weng1259/autospin/firmware/motor_control/README.md

# motor_control（已退役）

> ⚠️ **2026-04-13 起本目录的代码已停止维护**。
>
> 项目固件栈于 2026-04-13 迁移到 [grbl-Mega-5X](../grbl_spike/)，自研固件 `motor_control.ino`（Phase 2a/2b 版本）保留在此目录，**仅作 rollback snapshot**。
>
> - 当前固件配置见 [`docs/guides/04-grbl-固件配置.md`](../../docs/guides/04-grbl-固件配置.md)
> - 迁移背景见 [`docs/decision-log/ADR-001-migrate-to-grbl-stack.md`](../../docs/decision-log/ADR-001-migrate-to-grbl-stack.md)
> - 本目录的旧文档已归档到 [`docs/legacy/04-自研固件开发-archived.md`](../../docs/legacy/04-自研固件开发-archived.md) 和 [`docs/legacy/05-自研固件测试-archived.md`](../../docs/legacy/05-自研固件测试-archived.md)
>
> **不要在这里加新功能**。如果未来 grbl 路线出问题需要回滚，按 ADR-001 §回滚条件操作。
