weng1259/autospin/docs/hardware-specs.md

# 硬件特征表

> 从产品画册和驱动器手册中提取的关键参数，固件开发前必读。
>
> 数据来源标注：📘 = 产品画册, 📗 = 驱动器手册, 🔧 = 实测

---

## 一、运动模组（GH40）

> 📘 产品画册 p5 命名规则 + p8 40型号参数

| 参数 | 值 | 来源 |
|---|-----|---|
| 型号 | GH40-D75-X300S-Y300S-Z100S-57 | 铭牌 |
| 宽度 | 40mm | 📘 p8 |
| 传动方式 | **同步带**（非丝杆） | 📘 p8 |
| 同步带规格 | PU-HTD3M-15(钢丝)，齿距 3mm，带宽 15mm | 📘 p8 |
| 同步轮齿数 | **25 齿** | 📘 p8 |
| 导程 | **75mm/转**（25齿 × 3mm） | 📘 p8 |
| 最大速度 | ≤1.5 m/s | 📘 p8 |
| 重复定位精度 | ≤0.1mm | 📘 p8 |
| 直线度/回转差 | ≤0.05mm/300mm | 📘 p8 |
| 行程 | X=300mm, Y=300mm, Z=100mm | 铭牌 |

---

## 二、驱动器（2HSS57-C）

> 📗 驱动器手册

### 2.1 技术指标（📗 p9）

| 参数 | 值 |
|---|-----|
| 输入电压 | 24~60VDC（典型 36V，实际使用 24V） |
| 连续电流 | 4.5A 20kHz PWM |
| **最大脉冲频率** | **200kHz** |
| 保护 | 过流 8A±10%、过压 70VDC、位置超差可调 |

### 2.2 脉冲时序要求（📗 p13）

| 参数 | 最小值 | 固件实际值 |
|---|---|---|
| 脉冲宽度（t3/t4） | **≥ 2.5μs** | 当前最小 25μs（SPEED 9） |
| DIR 建立时间（t2） | **≥ 6μs** | 10μs |
| ENA 建立时间（t1） | ≥ 5μs | — |

### 2.3 拨码开关设置（📗 p14-16）

当前三台驱动器相同设置：

| 开关 | 状态 | 功能 |
|---|---|---|
| SW1 | OFF | 单脉冲模式（脉冲+方向） |
| SW2 | OFF | 默认方向（CCW） |
| SW3 | OFF | 细分设置 ↓ |
| SW4 | OFF | 细分设置 ↓ |
| SW5 | OFF | 细分设置 ↓ |
| SW6 | ON | → 组合 = **51200 细分/转** |
| SW7 | OFF | 指令平滑关闭 |
| SW8 | **OFF** | **闭环模式**（需 DB9 编码器） |

### 2.4 报警代码（📗 p16）

| 红灯闪烁次数 | 故障 | 备注 |
|---|---|---|
| 1 | 驱动器过流 | |
| 2 | 内部电压参考错误 | |
| 3 | 参数上传错误 | |
| 4 | 供电电压超过最大值 | |
| **5** | **位置偏差超限** | 🔧 Z轴刹车未释放时出现过 |
| 6 | 电机缺相 | |

### 2.5 关键内部参数（📗 p19-20）

| 参数 | 名称 | 默认值 | 说明 |
|---|---|---|---|
| P15 | 编码器线数选择 | 0 | 0=1000线, 1=2500线 |
| P16 | 位置超差阈值 | 400（×10=4000 counts） | 超过此值触发报警5 |
| P19 | 指令平滑 | 2 | |
| P20 | 自定义细分 | 8（×50=400） | SW3-6全ON时生效 |
| P22 | 脉冲滤波 | 3 | |

### 2.6 接线方式（📗 p10 + p18）

- 控制信号：**共阳极**接法（Arduino 5V → PLS+/DIR+，GPIO → PLS-/DIR-）
- 编码器：1000 线，四倍频计数 → 4000 counts/转（📗 p18）
- 刹车输出：集电极开路，需外接 24V + 继电器（📗 p6）
- ENA+/ENA-：当前悬空未接

---

## 三、计算参数

### 3.1 步距计算

```
每转脉冲数 = 51200（DIP 开关设定）
每转行程 = 75mm（同步带 25齿 × 3mm 齿距）
步距 = 51200 ÷ 75 = 682.67 步/mm
```

> ~~旧值"68.3步/mm"和"80步/mm"均不正确，来自早期"闭环÷10"的错误假设。~~
> **2026-03-26 已实测确认**：MOVE 6827 步 ≈ 10mm，682.67 步/mm 正确。

### 3.2 行程范围（步数）

| 轴 | 行程 mm | 步数（682.67步/mm） |
|----|---|---|
| X | 300 | 204,800 |
| Y | 300 | 204,800 |
| Z | 100 | 68,267 |

### 3.3 速度换算

| 场景 | 脉冲频率 | 线速度 | 备注 |
|---|---|---|---|
| 驱动器上限 | 200 kHz | 293 mm/s | 📗 p9 |
| 模组上限 | — | 1500 mm/s | 📘 p8，远高于驱动器上限 |
| 固件 SPEED 9 | 20 kHz（25μs） | 29.3 mm/s | |
| 固件 SPEED 5 | 2.5 kHz（200μs） | 3.7 mm/s | |
| 固件 SPEED 1 | 250 Hz（2000μs） | 0.37 mm/s | |
| 归零快寻 | 16.7 kHz（30μs） | 24.4 mm/s | |
| 归零慢寻 | 1.67 kHz（300μs） | 2.4 mm/s | |

### 3.4 归零时间估算

| 轴 | 最大行程 | 快寻速度 | 最大耗时 |
|----|---|---|---|
| Z | 100mm | 24.4 mm/s | ~4s |
| X | 300mm | 24.4 mm/s | ~12s |
| Y | 300mm | 24.4 mm/s | ~12s |
| **全轴** | — | — | **~28s** |

---

## 四、各轴物理特征

> 🔧 以下参数从实机测试获得，手册/画册中无法直接查到

| 参数 | X 轴 | Y 轴 | Z 轴 |
|---|---|---|---|
| 固件 invertDir | **true** | false | **false** |
| 归零方向 | 负方向（左） | 负方向（前） | **正方向（上）** |
| homeDirectionPositive | false | false | **true** |
| 原点传感器位置 | 左端 | 前端 | **顶部** |
| 引脚 PLS/DIR | D2/D3 | D4/D5 | D6/D7 |
| 传感器引脚 | D22/D23/D24 | D25/D26/D27 | D28/D29/D30 |
| 有刹车 | 否 | 否 | **是（DSTUR-T80 CH2）** |

### Z 轴刹车操作

```
运动前：发继电器命令 CH2 ON → 等 0.5s → 再发运动命令
运动后：收到运动完成 → 发继电器命令 CH2 OFF
注意：刹车未释放时发脉冲 → 闭环驱动器位置偏差报警（红灯闪5次）
```

---

## 五、信息溯源

| 问题 | 答案在哪 |
|---|---|
| 每转多少脉冲？ | 📗 驱动器手册 p15 细分表（SW3-6 组合） |
| 每转走多少 mm？ | 📘 产品画册 p8（导程 75mm，25齿×3mm） |
| 实际步/mm？ | 上面两个相除：51200 ÷ 75 = 682.67 |
| 脉冲能多快？ | 📗 驱动器手册 p9（200kHz）+ p13（脉宽≥2.5μs） |
| 驱动器报警什么意思？ | 📗 驱动器手册 p16（红灯闪烁次数表） |
| 刹车怎么控制？ | 📗 驱动器手册 p6（集电极开路，需外接 24V+继电器） |
| 各轴物理方向和传感器位置？ | ❌ 手册无，只能实测或看 3D 模型 |
