weng1259/autospin/docs/AutoSpin项目PPT介绍文档.md

# AutoSpin 智能旋涂与自动化实验平台——PPT 介绍文档

> 文档用途：用于项目汇报、阶段答辩、组会展示或实验室自动化平台介绍。  
> 内容依据：当前 `autospin` 项目代码、配置文件、迁移报告与安全设计。  
> 状态说明：本文严格区分“软件已实现”“可在 Mock/Dry-run 中验证”和“仍需真机标定/验收”的能力，不将规划内容表述为已完成成果。

---

## 一、项目概述

AutoSpin 是一套面向溶液法薄膜制备实验的智能自动化平台。项目以旋涂工艺为核心应用场景，将三轴龙门架、夹爪、移液器、旋涂电机、加热台、单轴滑台和继电器等设备整合到统一的软件系统中，使原本需要实验人员逐步完成的“取样—转移—移液—滴液—旋涂—退火”操作，可以由标准化实验协议进行编排、预检、执行和记录。

项目当前重点面向钙钛矿薄膜制备流程。例如，系统能够把基底从样品架搬运到旋涂台，吸取和滴加前驱体溶液，按设定的多段转速进行旋涂，在指定时间点滴加反溶剂，最后将样品转移至热台完成退火。通过设备抽象、语义化动作、坐标注册、安全校验和运行日志，AutoSpin 将多个独立硬件模块组织成一条可复用、可追踪的实验工作流。

AutoSpin 的价值不仅是“让设备自动运动”，更重要的是建立一套实验自动化的软件基础设施：实验参数可以结构化描述，硬件可以统一管理，实验流程可以在真实执行前预演，异常可以触发统一急停，执行结果可以形成结构化记录。这为提高实验重复性、降低人工操作差异、扩展高通量实验以及未来接入智能实验代理提供了基础。

---

## 二、项目背景与需求

传统旋涂实验通常包含多个连续且时间敏感的步骤：

1. 从样品架取出基底；
2. 将基底放置到旋涂台；
3. 安装枪头并吸取前驱体；
4. 在基底中心定量滴液；
5. 按多段转速曲线执行旋涂；
6. 在指定时刻滴加反溶剂；
7. 将样品转移到热台；
8. 在指定温度和时间下退火；
9. 记录实验参数和执行状态。

这些步骤涉及机械运动、串口通信、Modbus RTU、GRBL、继电器控制和严格的时间配合。人工操作容易受到熟练度、反应时间和记录完整性的影响；如果直接把各设备控制脚本简单串联，又容易出现端口冲突、坐标混乱、异常未处理和设备状态不一致等问题。

因此，AutoSpin 需要解决四类核心问题：

- **设备异构问题**：不同设备使用不同通信协议、串口参数和控制方式；
- **流程协同问题**：搬运、移液、旋涂和加热需要按照实验逻辑协调执行；
- **安全控制问题**：机械碰撞、未归零运动、超范围参数和通信失败必须被及时阻断；
- **实验复现问题**：实验参数、动作顺序、执行结果和错误信息需要结构化保存。

---

## 三、项目目标

AutoSpin 的总体目标是构建一套安全、模块化、可扩展的自动实验控制平台。

具体目标包括：

- 将多个实验设备封装为统一、清晰的后端接口；
- 使用配置文件集中管理串口、设备地址、坐标、限位和工艺边界；
- 使用结构化协议描述实验，而不是直接编写底层串口指令；
- 将实验协议编译为可执行的语义动作；
- 在真实硬件执行前支持 Mock 和 Dry-run 验证；
- 通过统一操作门控制并发任务，避免多个操作同时占用同一设备；
- 在动作失败时停止实验并触发系统级急停；
- 记录每个动作的参数、结果和错误，为复现和排查提供依据；
- 为后续批量实验、参数优化和智能实验代理预留标准接口。

---

## 四、系统组成

### 4.1 主要硬件模块

| 模块 | 主要作用 | 当前控制方式 |
|---|---|---|
| XYZ 龙门架 | 在样品架、旋涂台、热台和试剂区之间定位 | Arduino Mega 2560 + grbl-Mega-5X，115200 baud |
| 夹爪 | 抓取和释放基底 | 继电器 IO 控制 |
| 旋涂电机 | 执行多段转速旋涂 | DBLS400，Modbus RTU |
| 加热台 | 设置温度并执行退火 | AI-516，Modbus RTU |
| 移液器 | 归位、吸液、吐液、退枪头 | Modbus RTU |
| 单轴滑台 | 调节移液方向的位置 | RS485 |
| 继电器模块 | 控制夹爪、Z 轴刹车、真空阀等开关量 | 8 通道继电器协议 |
| 树莓派/上位机 | 运行 Python 控制系统和 Web 服务 | Python + FastAPI |

### 4.2 关键硬件参数

- 龙门架当前软件限位：
  - X：−310～−5 mm
  - Y：−310～−5 mm
  - Z：−110～−5 mm
- 旋涂电机配置能力上限：6000 rpm；
- 加热台配置温度上限：150 ℃，真实生产使用仍需完成上限确认；
- 移液器配置体积范围：0～1000 μL；
- 夹爪与龙门架 Z 轴刹车由同一继电器后端统一管理；
- 旋涂电机、加热台、移液器和单轴滑台共享可重配置的 RS485 物理总线。

这些参数来自当前配置文件。PPT 中应将其表述为“软件配置边界”，不能替代现场硬件标定和安全验收。

---

## 五、软件总体架构

AutoSpin 采用分层架构，将实验意图与底层硬件通信解耦：

```text
实验描述 / Web 页面
        ↓
协议模型与参数校验
        ↓
实验计划与语义动作
        ↓
生产安全预检
        ↓
DeviceRegistry 统一设备注册
        ↓
Backend 设备能力接口
        ↓
Adapter / Driver
        ↓
Serial / Modbus / GRBL / Relay
        ↓
真实实验硬件
```

各层职责如下：

- **实验描述层**：描述样品、液体、体积、旋涂曲线、加热条件和操作顺序；
- **协议层**：使用 Pydantic 数据模型验证字段、类型和单位；
- **工作流层**：把实验协议转换为取样、放样、吸液、滴液、旋涂和退火等语义动作；
- **安全层**：检查参数、坐标、设备可用性、工具偏移和串口占用；
- **设备注册层**：由 `DeviceRegistry` 统一创建并管理全部设备；
- **Backend 层**：向上提供稳定的设备能力，不暴露原始串口细节；
- **驱动层**：实现 GRBL、Modbus RTU、RS485 和继电器通信；
- **硬件层**：执行真实运动、移液、旋涂和温控动作。

这种架构的主要优点是：上层实验流程不需要知道某个寄存器地址或串口帧格式；当硬件型号或通信实现变化时，可以主要在驱动和适配层进行替换，而不必重写整个实验流程。

---

## 六、核心软件模块

### 6.1 配置管理

项目使用 YAML 文件集中保存设备和运行参数：

- `config/devices.yaml`：设备身份、型号、协议、后端类型和来源；
- `config/hardware.yaml`：串口、波特率、从站地址、超时、重试、量程和安全参数；
- `config/coordinates.yaml`：坐标系、软限位、工作站坐标、可信度和验收状态。

配置通过 `src/config.py` 加载，再由 `DeviceRegistry.from_config()` 创建后端。这样可以避免在网页、实验脚本和驱动中重复硬编码参数。

### 6.2 设备后端

`src/hardware/` 为每类硬件提供独立 Backend，包括：

- `gantry_backend.py`
- `gripper_backend.py`
- `spincoater_backend.py`
- `heater_backend.py`
- `pipette_backend.py`
- `linearstage_backend.py`
- `relay_backend.py`

Backend 是系统的重要安全边界。即使网页输入或上层流程出现问题，参数范围、设备状态和动作条件仍需要在 Backend 或执行前安全层中得到验证。

### 6.3 语义动作层

系统不让工作流直接发送原始 G-code、寄存器或继电器通道命令，而是使用具有实验含义的动作，例如：

- `PickSample`：抓取样品；
- `PlaceSample`：放置样品；
- `Aspirate`：吸取指定液体和体积；
- `Dispense`：在指定工位滴加液体；
- `SpinCoat`：执行多段旋涂并处理定时滴液；
- `Anneal`：设置热台温度、放置样品并保温；
- `Complete`：标记实验完成。

语义动作层是实验逻辑和硬件控制之间唯一的工作流边界。它能显著降低底层操作被误用的风险，也便于形成清晰的执行记录。

### 6.4 坐标注册系统

系统采用 GRBL 负向机器坐标系。坐标不再以散落的数字存在于各个脚本中，而是使用有语义的名称，例如：

- `stations.substrate_rack.pickup`
- `stations.spin_coater.operation`
- `stations.spin_coater.pipette_dispense`
- `stations.hotplate.place`
- `stations.reagent_rack.precursor_1`
- `stations.reagent_rack.antisolvent`
- `stations.waste.tip_eject`

每个坐标除了 XYZ 数值，还包含来源、可信度、是否需要硬件确认和是否允许生产执行等信息。生产模式会拒绝未验证、不可执行或需要确认的坐标，从而避免“坐标文件中有数值就直接运动”的风险。

### 6.5 Web 控制系统

项目当前提供基于 FastAPI 的 Web 服务。网页可以完成：

- 设备状态轮询；
- 系统急停；
- 龙门架归零、点动、绝对坐标移动和报警恢复；
- 加热台设定温度；
- 旋涂电机转速设置和启停；
- 移液动作；
- 单轴滑台位置控制；
- 继电器与夹爪控制；
- Routine 录制、保存、列表、重放、删除和中止；
- 实验预览和实验提交执行；
- 坐标、串口资源和启动安全状态诊断。

Web 层不会直接导入硬件驱动或串口库，而是通过 `DeviceRegistry` 调用统一后端。手动操作和实验执行共用全局 `OperationGate`，防止两个任务同时控制设备。

### 6.6 日志与可追踪性

每个语义动作都会形成结构化 `ActionRecord`，主要记录：

- 时间戳；
- 动作类型；
- 目标设备；
- 输入参数；
- 是否为 Dry-run；
- 是否成功；
- 执行结果；
- 错误信息。

这使系统能够回答“执行了什么、使用了哪些参数、在哪一步失败、失败后采取了什么安全措施”等问题，为实验复现、故障诊断和后续数据管理提供基础。

---

## 七、典型钙钛矿旋涂工作流

当前项目已经将 `perovskite_basic` 流程迁移为类型化实验计划。该流程保留了原始工艺条件，没有自动优化或静默修改化学参数。

典型流程如下：

```text
热台预热至 120 ℃
        ↓
从样品架抓取基底
        ↓
将基底放到旋涂台
        ↓
吸取 100 μL 前驱体
        ↓
在旋涂中心滴加前驱体
        ↓
1500 rpm 旋涂 10 s
        ↓
5000 rpm 旋涂 20 s
        ↓
总时间 20 s 时滴加 50 μL 反溶剂
        ↓
停止旋涂并抓取样品
        ↓
将样品转移到 120 ℃ 热台
        ↓
退火 480 s
        ↓
记录实验完成
```

该流程展示了 AutoSpin 的核心协同能力：

- 龙门架和夹爪完成基底搬运；
- 移液器和单轴滑台完成定量取液与滴液定位；
- 旋涂后端完成多段速度曲线；
- 定时事件在旋涂过程中触发反溶剂滴加；
- 加热后端负责温度设定、稳定等待和退火计时；
- 全部动作通过统一计划执行并生成结构化记录。

需要特别说明：该完整流程目前已在软件迁移和 Dry-run 中执行成功；真实全自动运行仍受坐标、工具偏移和分阶段硬件验收条件约束。

---

## 八、安全设计

自动化实验系统的关键不是“能否运行”，而是“在异常条件下能否拒绝危险动作并安全停止”。AutoSpin 当前采用多层安全机制。

### 8.1 执行前安全预检

真实实验开始前，系统会组合检查：

- 协议字段和单位是否合法；
- 转速、体积和温度是否超出配置范围；
- 坐标是否存在、可执行且已经确认；
- 工具偏移是否完成确认；
- 所需设备是否已经注册并可用；
- 物理串口资源是否被其他任务占用；
- 龙门架和其他关键设备是否满足启动条件。

### 8.2 运动安全

- 未归零时不执行绝对实验坐标；
- 所有实验坐标必须经过坐标注册表解析；
- Backend 软件限位是最终边界；
- XY 转移需要考虑安全 Z 高度；
- 与移液相关的动作会先将单轴滑台移动到安全位置，再执行龙门架运动；
- 完成吸液或滴液后，单轴滑台会回到安全位置。

### 8.3 通信与资源安全

- 每个物理串口在生产运行中只有一个所有者；
- 共享 RS485 总线由统一管理器串行化访问并按设备参数重配置；
- 手动控制和自动实验共用操作冲突门；
- 串口、GRBL、继电器或 RS485 操作失败不能被伪装成成功。

### 8.4 失败处理

- 任一非 Dry-run 动作失败后立即停止后续计划；
- 系统触发统一 `SystemEstop`；
- 急停优先停止龙门架，并按照当前策略释放夹爪；
- 错误以结构化形式返回，便于网页、日志和未来智能代理判断。

### 8.5 Dry-run

Dry-run 会完成协议、动作、坐标、设备和安全规则验证，但不会执行真实硬件 I/O。它适合用于：

- 新实验流程预演；
- 参数范围检查；
- 动作顺序检查；
- Web 页面预览；
- 硬件接入前的软件测试；
- 降低首次真机运行风险。

---

## 九、项目当前完成情况

根据当前代码和迁移报告，以下软件能力已经落地：

- 设备配置与统一注册；
- 龙门架、继电器、夹爪、旋涂电机、加热台、移液器和单轴滑台后端；
- 串口所有权、共享 RS485 串行访问、重连和生命周期管理；
- 协议 Schema、单位验证和模板；
- 语义坐标、别名、来源和生产预检；
- 语义动作执行；
- 钙钛矿基础旋涂工作流；
- Web 手动设备控制；
- Web 实验预览和执行接口；
- 全局操作冲突控制；
- Dry-run、结构化错误、动作记录和系统急停；
- Mock 和自动化测试体系。

更准确的阶段结论是：

> AutoSpin 的软件迁移路径已经完成，并且完整实验流程可在 Dry-run 中执行；真实自动实验仍需要完成关键坐标、工具偏移和时序的现场标定与分阶段硬件验收。

---

## 十、当前限制与待完善内容

为了保证汇报客观准确，PPT 中建议主动说明以下限制：

1. **真实硬件验收尚未全部完成**  
   部分模块已经完成代码迁移，但仍标记为硬件未确认；真实连续运行需要按设备逐级验收。

2. **工具偏移仍需标定**  
   当前 `tool_offsets` 尚未建立。夹爪和移液器相对于龙门架基准的几何偏移，是生产执行的重要条件。

3. **部分坐标仍需确认**  
   多个核心工位已有可执行坐标，但部分试剂位置仍标记为中等可信度、需要硬件确认。

4. **工艺时序需要真机验证**  
   反溶剂定时滴加、热台稳定等待、夹持高度、枪头拾取和样品放置等动作，需要在真实硬件上验证误差和重复性。

5. **长期实验数据管理仍需扩展**  
   当前已有结构化动作记录；面向大规模实验时，还需要选择长期实验记录、样品数据和表征结果的持久化方案。

6. **Web 实验构建功能仍可增强**  
   当前已支持实验预览和执行，但尚未完整实现图形化多轮实验生成、坐标编辑、批量模板参数编辑和样品编号自动展开。

7. **夹爪缺少物理反馈**  
   当前夹爪状态只代表最后一次控制命令，不代表实际夹持成功；未来可增加到位、力或样品检测传感器。

---

## 十一、项目创新点与工程价值

### 11.1 从设备脚本升级为实验平台

AutoSpin 不只是将多个串口脚本放在一起，而是建立了“协议—计划—动作—设备—驱动”的完整链路，使实验意图能够稳定地映射为硬件动作。

### 11.2 语义动作替代底层命令

上层流程使用“抓取样品”“吸取 100 μL 溶液”“执行两段旋涂”等实验语义，而不是直接操作寄存器、继电器通道和 G-code。这既提高可读性，也降低误操作风险。

### 11.3 坐标不仅是数值，也是可审计数据

坐标注册表同时保存位置、来源、可信度、验收状态和可执行状态。系统可以拒绝使用尚未确认的坐标，使标定状态真正进入软件安全逻辑。

### 11.4 Dry-run 与真实执行共用同一条逻辑链

实验预演不是另外写一套演示代码，而是在同一个协议、动作和安全校验体系中禁止硬件 I/O。这有助于确保预演结果与真实执行计划一致。

### 11.5 统一资源管理和急停

设备端口、共享总线和并发任务由统一机制管理；动作失败后能够停止整个实验并触发系统急停，而不是只让某个局部脚本报错退出。

### 11.6 为智能实验室预留接口

结构化协议、类型化 API、语义动作、状态查询、结构化错误和运行记录，为未来接入自动参数生成、闭环优化和大模型实验代理提供了更安全的接口基础。

---

## 十二、未来工作

后续工作建议分为三个阶段推进。

### 阶段一：完成真机 commissioning

- 标定夹爪和移液器工具偏移；
- 确认全部工位坐标；
- 验证龙门架安全路径和软限位；
- 验证枪头拾取、吸液、滴液和退枪头；
- 测试多段旋涂及定时滴液误差；
- 测试热台升温稳定性和退火计时；
- 完成急停、断线、堵转和碰撞等异常测试。

### 阶段二：提升实验生产能力

- 建立图形化 Experiment Builder；
- 支持模板参数编辑和多轮实验生成；
- 实现样品、枪头和试剂位自动展开；
- 保存长期实验记录、设备状态和样品元数据；
- 增加权限、审计和实验恢复机制；
- 增加夹爪、样品和液面检测反馈。

### 阶段三：构建智能闭环实验

- 接入表征设备和实验结果数据库；
- 将实验参数与薄膜性能关联；
- 使用优化算法自动提出下一轮参数；
- 由智能代理在语义工具白名单内执行实验；
- 形成“设计—执行—表征—分析—再设计”的闭环。

---

## 十三、总结

AutoSpin 已经从早期的独立硬件控制脚本，发展为一套具有统一配置、设备抽象、协议建模、工作流编排、Web 控制、安全预检、Dry-run 和运行记录能力的自动实验平台。

项目当前已经完成主要软件模块迁移，并能够在 Dry-run 中执行完整的钙钛矿旋涂与退火流程。系统的核心优势是将实验步骤转化为可验证、可执行、可追踪的语义动作，同时把坐标、参数、串口资源和异常处理纳入统一安全框架。

下一阶段的重点不是继续增加未经验证的功能，而是完成工具偏移、关键坐标、工艺时序和异常场景的真机验收。在此基础上，AutoSpin 可以进一步扩展为多轮实验平台，并逐步实现面向材料研究的高通量和智能闭环实验。

一句话概括：

> **AutoSpin 是一套以旋涂工艺为起点、以安全可追踪的实验自动化为核心、面向未来智能实验室扩展的模块化软硬件平台。**

---

# PPT 页面建议（15 页）

## 第 1 页：封面

**标题：** AutoSpin 智能旋涂与自动化实验平台  
**副标题：** 面向钙钛矿薄膜制备的模块化实验自动化系统

建议配图：设备整体照片或“龙门架—旋涂台—热台—移液器”的平台示意图。

讲解重点：用一句话说明项目将取样、滴液、旋涂和退火整合为可编排、可预检、可记录的自动实验流程。

## 第 2 页：研究背景

**标题：** 传统旋涂实验存在重复性与协同控制问题

- 操作步骤多，且部分步骤对时间敏感；
- 不同设备协议不统一；
- 人工操作带来批次差异；
- 实验过程和异常难以完整记录；
- 简单脚本串联难以保证安全与可维护性。

建议图示：左侧人工操作流程，右侧列出重复性、时间误差、记录缺失和安全风险。

## 第 3 页：项目目标

**标题：** 从单设备控制升级为完整实验流程自动化

- 自动完成样品搬运、移液、旋涂和退火；
- 使用结构化实验协议驱动设备；
- 在真机运行前完成 Dry-run 和安全检查；
- 记录动作、参数、结果与异常；
- 为多轮实验和智能实验室提供基础。

## 第 4 页：平台硬件组成

**标题：** 七类硬件模块构成自动实验工作站

展示龙门架、夹爪、移液器、旋涂电机、加热台、单轴滑台和继电器模块。

建议布局：使用平台俯视示意图，在对应位置标注设备名称与作用；避免把所有通信参数放在本页。

## 第 5 页：系统架构

**标题：** 分层架构将实验逻辑与底层通信解耦

建议展示：

```text
实验协议 → 实验计划 → 语义动作 → 安全预检
       → DeviceRegistry → Backend → Driver → 硬件
```

讲解重点：工作流不直接发送 G-code 或写寄存器，设备替换主要影响底层而不影响实验逻辑。

## 第 6 页：设备与通信

**标题：** 统一管理 GRBL、Modbus、RS485 与继电器设备

使用表格展示：

| 类别 | 设备 | 协议 |
|---|---|---|
| 运动 | XYZ 龙门架 | GRBL |
| 工艺 | 旋涂电机、加热台、移液器 | Modbus RTU |
| 定位 | 单轴滑台 | RS485 |
| 开关量 | 夹爪、刹车、真空阀 | Relay IO |

## 第 7 页：实验工作流

**标题：** 钙钛矿制备流程被编译为可执行动作链

建议使用横向流程图：

取基底 → 放旋涂台 → 吸前驱体 → 滴液 → 两段旋涂 → 定时滴反溶剂 → 转移热台 → 退火

在关键节点标出：100 μL、1500 rpm/10 s、5000 rpm/20 s、20 s 时滴加 50 μL、120 ℃/480 s。

## 第 8 页：语义动作设计

**标题：** 用实验语言控制设备，而不是暴露底层命令

左侧展示 `PickSample / Aspirate / SpinCoat / Anneal`；右侧展示系统在后台完成坐标解析、设备选择、串口通信和结果记录。

讲解重点：语义动作提高流程可读性，同时限制高风险底层能力被直接调用。

## 第 9 页：坐标与标定

**标题：** 坐标注册表让位置数据具备来源和验收状态

- 坐标使用工位语义名称；
- 保存数值、来源、可信度和确认状态；
- 未确认或不可执行坐标不能进入生产运行；
- 工具偏移是下一阶段真机标定重点。

建议图示：样品架、旋涂台、热台、试剂架和废料区的二维工位分布图。

## 第 10 页：安全机制

**标题：** 多层校验覆盖参数、坐标、资源与失败处理

建议画成四道安全门：

协议/单位 → 参数范围 → 坐标/标定 → 设备/串口状态 → 执行

下方补充：任一真实动作失败 → 停止计划 → 系统急停 → 记录错误。

## 第 11 页：Web 控制与可观测性

**标题：** Web 页面统一支持手动调试、状态诊断和实验执行

- 设备状态与手动控制；
- 急停和报警恢复；
- Routine 录制与重放；
- 实验预览与执行；
- 坐标、串口和启动安全诊断；
- 结构化动作记录。

建议配图：当前 Web 页面截图，重点框选设备状态、实验控制和急停区域。

## 第 12 页：软件验证

**标题：** Mock、Dry-run 与自动化测试降低真机调试风险

- Mock：无需连接真实设备即可验证页面和流程；
- Dry-run：执行完整验证链，但不产生硬件 I/O；
- 自动化测试：覆盖设备后端、配置、坐标、实验生成、Web API 和安全逻辑；
- 真机测试：按设备和动作逐级验收，不直接进行全流程冒险测试。

## 第 13 页：当前成果

**标题：** 核心软件链路已经贯通

- 多设备后端与统一注册完成；
- 语义坐标和动作执行完成；
- 钙钛矿基础流程完成迁移；
- Web 预览、执行和诊断接口完成；
- 生产安全预检、资源管理和系统急停完成；
- 完整流程可在 Dry-run 中执行。

页脚醒目标注：真实全自动执行仍需完成关键标定与分阶段硬件验收。

## 第 14 页：现有限制与下一步

**标题：** 下一阶段重点是真机标定、验收和实验生产化

- 标定夹爪/移液器工具偏移；
- 确认全部关键工位坐标；
- 验证滴液时序、加热稳定和夹持重复性；
- 建立长期实验数据存储；
- 完善多轮实验构建页面；
- 增加夹持和样品状态传感反馈。

## 第 15 页：总结与展望

**标题：** 从自动旋涂走向安全可追踪的智能实验平台

建议保留三句话：

1. AutoSpin 已贯通实验协议到多设备执行的软件链路；
2. 安全校验、Dry-run 和结构化记录是系统的核心工程价值；
3. 完成真机验收后，可进一步扩展到高通量和智能闭环实验。

---

# 3～5 分钟项目介绍参考讲稿

AutoSpin 是一套面向钙钛矿薄膜制备的智能旋涂与自动化实验平台。我们的目标不是只控制一台旋涂电机，而是把样品抓取、移液滴加、多段旋涂、反溶剂定时滴加和热台退火等操作整合为一条完整、可验证的实验流程。

平台在硬件上包括 XYZ 龙门架、夹爪、移液器、旋涂电机、加热台、单轴滑台和继电器模块。不同设备分别使用 GRBL、Modbus RTU、RS485 和继电器协议。为了避免实验流程直接依赖这些底层通信细节，系统采用分层设计：上层使用结构化协议描述实验，中间层将协议编译成抓取样品、吸液、滴液、旋涂和退火等语义动作，底层再通过统一的设备注册和 Backend 调用真实驱动。

以当前迁移完成的钙钛矿基础流程为例，系统首先把热台设置为 120 摄氏度，然后从样品架抓取基底并放到旋涂台，吸取 100 微升前驱体并滴加到基底中心，随后执行 1500 转每分钟 10 秒和 5000 转每分钟 20 秒的两段旋涂，并在总时间 20 秒时滴加 50 微升反溶剂。旋涂结束后，系统将样品转移到热台并退火 480 秒。整个过程由类型化实验计划驱动，每一步都会生成结构化动作记录。

安全性是本项目的重要设计重点。实验执行前，系统会检查参数范围、坐标状态、工具偏移、设备可用性和串口资源占用。龙门架未归零时不能执行绝对实验坐标；未确认或不可执行的坐标不能进入生产运行；任何真实动作失败后，系统会停止后续计划并触发统一急停。同时，系统支持 Dry-run，可以在不产生硬件动作的情况下预演完整流程和验证参数。

目前，设备后端、统一配置、语义动作、坐标注册、钙钛矿工作流、Web 控制、实验预览与执行、安全预检和急停链路已经完成软件集成，完整流程能够在 Dry-run 中运行。下一阶段的重点是完成工具偏移、关键工位坐标、滴液时序和热台稳定性的真机标定与分阶段验收。完成这些工作后，AutoSpin 可以进一步扩展到多轮实验、长期数据管理和基于实验结果的智能闭环优化。

总体而言，AutoSpin 是以旋涂工艺为起点，面向安全、可复现和可扩展实验自动化的一套模块化平台。
