weng1259/autospin/docs/spin-chatgpt.md

下面是我按你要求做的联网调研结论。先给一句总判断：

**你现在最值得停止自研的，是 Layer 1 的运动控制内核、Layer 2 的串口/G-code 调度与 UI、Layer 3 的串口并发与实验记录骨架。**
对你这套 **Mega 2560 + 外置 step/dir 闭环驱动器** 的现状，最稳的开源迁移路线不是“全家桶重来”，而是：

**Layer 1 先换成 `grbl-Mega-5X`，Layer 2 用 `cncjs`，Layer 3 自己写一个轻量 Python orchestrator（`pyserial-asyncio + pymodbus`），Layer 5 用 `Node-RED` 或 `Streamlit + SQLite`。**
至于 `FluidNC / Smoothieware / g2core / LinuxCNC`，不是不好，而是**跟你当前主控硬件不在一个轨道上**。([GitHub][1])

---

## 1) 速览表格

### Layer 1：Arduino Mega 2560 上的运动控制固件

| 项目 | License | 最近提交 | Star | 是否匹配我们的硬件 | 核心能力 | 不适合的原因 |
| --- | --- | ---: | ---: | --- | --- | --- |
| grbl-Mega-5X | GPL 系 GRBL fork | 2 年前 | 386 | **匹配** | Mega2560；step/dir；G-code；约 30kHz 脉冲；支持 homing / soft limit / status / hold；多轴扩展 | 活跃度一般；社区不如主流 GRBL/Marlin 大 |
| gnea/grbl-Mega | License 文件存在 | 8 年前 | 516 | **匹配但过旧** | Mega2560；G-code；GRBL 1.1 系命令/设置 | **疑似停止维护**；老旧 |
| Marlin | GPL-3.0 | 约 2 周前（bugfix 分支） | 17.4k | **可用，但不优先** | AVR/ATmega 平台广泛支持；加减速、endstop、软件限位、homing、丰富 IO/M-code | 更偏 3D 打印机世界观；配置面复杂；对你这种“实验仪器三轴平台”有点重 |
| FluidNC | GPL-3.0 | 2026-03 发布活跃 | 未在本次表中取值 | **硬件不符** | ESP32 CNC 固件；Web UI；软/硬限位；homing | **不跑 Mega2560** |
| Smoothieware | GPL-3.0 | 5 个月前 | 1.4k | **硬件不符** | LPC17xx 32-bit；G-code；CNC/打印通用 | **不跑 Mega2560** |
| Klipper | GPL-3.0 | 5 天内持续活跃 | 11.4k | **部分匹配** | MCU+Host 分体；支持 ATmega2560；高层规划强；树莓派配套成熟 | 强依赖树莓派 host；更偏 3D 打印生态；非典型 CNC sender/workflow |
| TinyG / g2core | License 文件存在 | 3 年前 | 673 | **硬件基本不符** | 9 轴；三阶/jerk 规划；JSON/REST；高性能 | 默认目标 **Arduino Due**，不是 Mega2560 |
| LinuxCNC | GPL-2.0 等 | 活跃，2026-01 仍发版 | 2.2k | **硬件不符（作为 Mega 固件）** | 工业级运动控制；HAL；硬实时；丰富 I/O/联锁 | 不是刷到 Mega 上的固件；通常需要 x86/Linux+实时环境+合适 I/O 板 |

表中硬件匹配、星数、提交时间来自各仓库 README/仓库页/搜索快照；`grbl-Mega-5X` 和 `gnea/grbl-Mega` 都明确写了“runs on an Arduino Mega2560 only”；`FluidNC` 明确是 ESP32；`Smoothieware` 明确是 LPC17xx；`g2core` 默认目标是 Arduino Due；`LinuxCNC` 是独立 Linux 控制系统；Klipper 文档明确有 Atmega2560 支持。([GitHub][1])

---

### Layer 2：上位机运动控制 / G-code 发送器

| 项目 | License | 最近提交 | Star | 是否适合树莓派/API 集成 | 核心能力 | 不适合的原因 |
| --- | --- | ---: | ---: | --- | --- | --- |
| cncjs | MIT | v1.11.0 / 2026-03-12；README 2 个月内改动 | 2.6k | **很适合** | Web UI；支持 Grbl/Marlin；macro；widget；Socket.IO 控制接口；多客户端 | 主要是事件接口，不是“工业 REST”风格 |
| bCNC | GPL-2.0 | 2 个月前 | 未在本次表中取值 | **中等适合** | Python 写成；树莓派友好；强 MDI / sender / probe / CAM 小工具 | GUI 老派；Web/API 能力弱于 cncjs |
| UGS | GPL-3.0 | 3 周内仍有更新；v2.1.22 | 2.2k | **一般** | 跨平台；插件多；支持 Web pendant API | Java 平台偏重；自动化集成不如 cncjs 顺手 |
| Candle | GPL-3.0 | 活跃度一般 | 未在本次表中取值 | **较弱** | 轻量桌面 G-code sender | 无明显 API 能力；更像手动控制器 |
| gSender | 开源仓库可见  | 活跃 | 未在本次表中取值 | **一般** | 现代 UI；面向 hobby CNC | 更偏桌面 GUI，API 集成不突出 |
| OpenBuilds Control | 开源仓库 | 11 个月前 | 242 | **一般** | 面向 GRBL；带 API 文件；手机无线 jog | 生态偏 OpenBuilds / BlackBox；通用编排能力一般 |

`cncjs` 仓库页明确列出支持 Grbl/Grbl-Mega/Marlin/Smoothieware/TinyG/g2core、支持自定义 widget/MDI、可小屏/平板使用，并有 `cncjs-controller` 事件库；`UGS` README 明确含 `ugs-pendant` 且社区讨论指出可通过 web pendant API 发 HTTP 请求；`OpenBuilds Control` 仓库里有 `api.doc` 文件；`bCNC` 明确是 Python 编写、在 Raspberry Pi 上验证过。([GitHub][2])

---

### Layer 3：树莓派 / Python 侧多模块协调框架

| 项目 | License | 最近提交 | Star | 是否适合“小作坊 DIY + 单机” | 核心能力 | 不适合的原因 |
| --- | --- | ---: | ---: | --- | --- | --- |
| PyLabRobot | MIT | 2 天前 | 426 | **适合做上层抽象** | Python async；实验设备统一抽象；可视化；社区活跃 | 默认关注液体处理/实验设备，不直接替代 CNC sender |
| Opentrons API / opentrons | Apache-2.0 | 1 小时前；9.0.0 于 2026-04-07 | 498 | **部分适合** | 协议化实验流程、液体处理经验丰富 | 强绑定 Opentrons 生态；不是通用设备总线框架 |
| ChemOS | 未在片段中取值 | 6 年前 | 未在本次表中取值 | **不太适合** | 化学实验编排理念强 | **明显老旧**；对单机 DIY 偏重 |
| ROS 2 / MoveIt 2 | BSD-3-Clause 等 | 活跃 | MoveIt2 仓库活跃 | **不推荐首发** | 机器人规划、坐标系、动作框架成熟 | 学习/部署成本高，明显超出你的最小系统需求 |
| pymodbus | BSD 系项目（仓库页显示活跃） | 现在/近几周持续更新；v3.13.0 于 2026-04-12 | 2.7k | **强烈适合** | Modbus client/server/simulator；同步+异步 API | 比 minimalmodbus 更“工程化”，学习稍陡 |
| minimalmodbus | Apache-2.0 | 3 年前 | 343 | **适合简单设备** | RTU/ASCII 简洁易用 | **疑似维护放缓**；异步支持差 |
| pyserial-asyncio | License 文件存在 | 4 年前 | 280 | **适合做串口协调骨架** | asyncio 串口 transport/protocol | 维护慢；Windows 支持历史上有歧义 |

`PyLabRobot` README 明确强调纯 Python、跨平台、async/await、可控制多类实验设备；`Opentrons` 仓库当前仍非常活跃，但其 API 主要围绕自家 OT-2/Flex；`ChemOS` 主仓库最近提交已是 6 年前；`pymodbus` 当前仍在持续开发并在 2026-04-12 发了 v3.13.0；`minimalmodbus` 最近提交约 3 年前；`pyserial-asyncio` 最近提交约 4 年前、最新 release 2021。([GitHub][3])

---

### Layer 4：旋涂工艺本身 / Spin coater 专项开源

| 项目 | License | 最近提交 | Star | 是否适合直接借鉴 | 核心能力 | 不适合的原因 |
| --- | --- | ---: | ---: | --- | --- | --- |
| Maasi | GPL-3.0 | 2021；项目自称**不再积极维护** | 56 | **适合借鉴旋涂机本体设计** | 开源旋涂机整机；GUI；Arduino/ESP32；最高 8000 RPM  | **停止维护**；不是你现有三轴平台控制栈 |
| PASCAL | MIT | 2 个月前 | 22 | **很适合借鉴工艺编排** | 自动化 spin coating + annealing + 调度 + 规划 | 系统规模更大，含自定义硬件/研究代码 |
| AShnier/SpinCoater | 仓库可见 | 有论文关联 | 未在本次表中取值 | **适合借鉴转速/时间控制** | Arduino 旋涂控制代码 | 功能窄，不是整机编排 |
| droneSpinCoater | 仓库可见 | 活跃度未知 | 未在本次表中取值 | **适合借鉴低成本转台控制** | Arduino + OLED + BLDC/vacuum chuck | 偏单机玩具化，不含多模块协同 |

`Maasi` README 直接写了 “no longer actively maintained”；但它仍是少数完整公开的开源旋涂机项目。`PASCAL` README 明确说明其目标就是自动化 spin coating 与 annealing，并展示了液体处理与 spin coater 协同；对应 2024 论文还公开提到他们用自定义 spin coater、调度与并行样品流程。([GitHub][4])

---

### Layer 5：实验数据记录与 UI

| 项目 | License | 最近提交 | Star | 是否适合单机实验室场景 | 核心能力 | 不适合的原因 |
| --- | --- | ---: | ---: | --- | --- | --- |
| Node-RED | Apache-2.0 | 2 天前；4.1.8 于 2026-03-24 | 23k | **很适合** | 流程编排；HTTP/串口/MQTT 节点；可视化流；树莓派友好 | 复杂业务逻辑会变“线团图” |
| Streamlit | Apache-2.0 | 2 天前；1.56.0 于 2026-03-31 | 44.2k | **很适合** | Python 直接出 Web UI；参数面板；表格图表；低门槛 | 前端交互编排不如 Node-RED |
| Gradio | Apache-2.0 | 2 周内文件仍在更新；6.12.0 于 2026-04-10 | 42.3k | **一般** | 快速搭建界面/API；组件多 | 更偏 demo/AI app，不像实验台 control panel |
| Grafana | 开源仓库活跃 | 5 天前 | 大项目 | **适合做只读看板** | 仪表盘、时序图、告警 | 不是实验控制 UI，本身不解决流程编排 |
| Home Assistant Core | 开源仓库活跃；2026.4.2 | ~86k | **不推荐主控** | 自动化规则、仪表板、本地运行 | 把实验平台当智能家居会出现抽象不贴合、实体模型过重 | |

`Node-RED`、`Streamlit`、`Gradio` 的仓库都非常活跃；`Node-RED` 和 `Streamlit` 对你这种“树莓派单机、自己写 Python 逻辑、再给人一个控制/记录 UI”的场景更贴；`Home Assistant` 虽然活跃且本地运行友好，但它的实体/自动化模型更适合家居设备，不适合作为实验主控。([GitHub][5])

---

## 2) 每层 Top 1-2 推荐

### Layer 1 推荐 1：**grbl-Mega-5X**

**为什么推荐**

它最直接击中你现在的痛点：

* 你的 `pulse/dir + 外置闭环驱动器` 方案，本质上和 GRBL 这类固件的目标场景高度一致；闭环驱动器对上位控制来说仍然就是 step/dir 负载。
* `grbl-Mega-5X` 明确支持 **Mega2560**，有标准 **G-code + status/report + hold/resume**，比你现在自写的行文本协议稳很多。
* README 明确提到异步 operation 和稳定脉冲，目标脉冲能力约 **30kHz**；这正对应你“脉冲时序不够平稳、阻塞解析、运动中降速命令不生效”的问题。
* GRBL 系有比较成熟的 **homing / soft limit / alarm / feed hold / jog** 机制，可直接替掉你现在“单阶段归零 + 坐标安全性差 + 急停联锁没做”的一大半问题。([GitHub][1])

**落地步骤**

1. 用一块单独 Mega，先只接 **X 轴驱动器 + 3 个限位**，刷 `grbl-Mega-5X`。
2. 只验证：步向极性、steps/mm、max rate、acceleration、homing、hard/soft limit。
3. 再接 Y/Z，确认 Z 刹车继电器在 homing / idle / alarm 的联动策略。
4. 最后才把网页控制面板切到发 G-code/status query，而不是直接串口私有命令。

**预计工时**

* 最小闭环验证：**1–2 天**
* 三轴接通并稳定 homing：**2–4 天**
* Web 面板切 G-code：**1–2 天**

**已知坑**

* 项目近两年仍有提交，但并不算很活跃；你要接受“自己看 issue/源码”的现实。([GitHub][6])
* 社区里有人在 soft limit / homing 方向配置上踩坑，尤其正负方向和 max travel 设定容易错。([GitHub][7])
* 你这套 2HSS57-C 最高可到 51200 脉冲/转，而 AVR 平台总脉冲预算有限；**不要指望 Mega 在极高细分 + 高转速下依然宽裕**。这不是 GRBL 的 bug，而是 8-bit AVR 的硬上限问题。这个点也是后面我建议保留 future rollback 的原因。([GitHub][1])

**链接**

* GitHub：`fra589/grbl-Mega-5X` ([GitHub][6])
* 参考命令/设置：GRBL 命令与设置文档 ([GitHub][8])

---

### Layer 1 推荐 2：**Marlin（仅当你非常需要更多可定制 IO / M-code 行为）**

**为什么推荐**

* 它对 **ATmega2560** 很成熟，社区大，活跃度远高于 grbl-Mega 系 fork。([GitHub][9])
* 你能比较容易把 **Z 刹车继电器、夹爪 relay、endstop 组合、软限位、homing feedrate** 都塞进现有配置和自定义 G-code/M-code。
* 如果你后面要把平台做成“非典型 3D 打印机式三轴工装”，Marlin 的配置自由度和外设生态比老 Mega GRBL fork 更宽。([Marlin Firmware][10])

**不如 grbl-Mega-5X 的地方**

* 你的设备不是 3D 打印机。Marlin 虽然能干，但很多抽象并不贴你的场景。
* sender/生态虽然能跑 G-code，但对“实验平台”没有 GRBL 那么自然。
* 配置复杂，未来维护成本未必比 GRBL 低。([GitHub][9])

---

### Layer 2 推荐 1：**cncjs**

**为什么推荐**

* 它是你现在“网页控制面板”的最自然替代品：**原生 Web UI、树莓派友好、多客户端、支持自定义 widget / MDI / macro**。([GitHub][2])
* 对 GRBL/Grbl-Mega 兼容明确，并且有 `cncjs-controller` 事件式控制库，适合你未来把它挂到 MCP Server/API 网关。([GitHub][2])
* 它能直接解决你现在的“自己做 Web Serial + 串口协议过于简陋”的痛点，把串口 sender、队列、状态显示、jog、hold/resume 交给成熟项目。([GitHub][2])

**落地步骤**

1. 树莓派安装 cncjs。
2. 先只连 Layer 1 固件，确认 jog / home / hold / reset / macros。
3. 再做两个 macro：`夹爪开合`、`Z 刹车释放/抱闸`。
4. 最后把实验流程控制从“网页按钮直串口”改成“Python orchestrator 调 cncjs / G-code / 设备驱动”。

**预计工时**

* 部署：半天
* 机器 profile + macro：半天到 1 天
* 接入你自己的上层服务：1–2 天

**已知坑**

* 官方更偏 **Socket.IO 事件接口**，不是干净的 REST-first 风格；你如果特别想要 REST，需要自己包一层。([GitHub][11])
* 旧 wiki/安装文档里曾出现 Node 版本相关困扰；部署时要按当前 release 跑。([GitHub][12])

**链接**

* GitHub：`cncjs/cncjs` ([GitHub][2])
* 控制库：`cncjs/cncjs-controller` ([GitHub][13])

---

### Layer 2 推荐 2：**UGS**

**为什么推荐**

* 如果你更偏好“成熟桌面 sender + 现成 pendant API”，UGS 是稳的。
* 社区讨论明确提到它的 **web pendant API** 可以用 HTTP 请求远程触发命令。([Reddit][14])

**为什么排在 cncjs 后面**

* Java 平台更重。
* 作为树莓派上“系统内核的一部分”不如 cncjs 贴合。
* 你的目标是以后让 Mac/手机经 Wi-Fi 接入，cncjs 的 Web 思路更顺。([GitHub][15])

---

### Layer 3 推荐 1：**轻量自研 orchestrator：`pyserial-asyncio + pymodbus + SQLite`**

这层我**不推荐你整层外包给某个大框架**。

**为什么推荐**

* 你真正需要的是：
  “三轴运动状态机 + 夹爪 Modbus RTU + 旋涂模块 RS485 + 移液模块 RS485 + 实验记录”
  这更像一个**小型设备编排器**，不是一个现成大平台能直接替代的东西。
* `pymodbus` 现在很活跃，有同步/异步 API，适合夹爪和未来 RS485 模块。([GitHub][16])
* `pyserial-asyncio` 虽然维护慢，但作为串口 transport 足够，配合 `asyncio.Task` 很适合你做多设备并发。([GitHub][17])
* 这条路能让你把“控制”和“记录”从第一天就结构化，而不是散落在前端页面按钮里。

**建议架构**

* `motion_service.py`：只负责 G-code 会话 / 状态读取 / 机台锁
* `gripper_service.py`：Modbus RTU 封装（位置、力度、速度）
* `spin_service.py`：未来旋涂模块协议
* `pipette_service.py`：未来移液模块协议
* `run_engine.py`：实验 recipe / step orchestration
* `run_log.db`：SQLite 记录所有 command / ack / alarm / result

**这层能解决的痛点**

* 多模块统一协调层
* 实验记录持久化
* 串口阻塞等待
* 安全状态机（未归零不可执行某类动作）
* 为以后 MCP/API 网关留出清晰边界

---

### Layer 3 推荐 2：**PyLabRobot（只拿它的抽象思路，不要强行全栈迁移）**

**为什么推荐**

* 它是少数真正现代化、活跃、Python async 的实验自动化 SDK。([GitHub][3])
* 它给你一个很好的参考：
  **设备对象化、资源对象化、动作 await 化、可视化/测试分离**。
* 如果你后面真要做“移液 + 平台 + 实验 protocol”的可维护系统，它比直接照抄工业 PLC 思路更适合软件人。([GitHub][3])

**为什么不是第一推荐**

* 它不是给你现成接 GH40 + 夹爪 + 旋涂仪的。
* 你仍然得自己写 backend adapter。

---

### Layer 4 推荐 1：**PASCAL**

**为什么推荐**

这不是“能直接用”的项目，而是**最值得偷设计**的项目。

* 它公开做的正是 **spin coating + 液体处理 + 调度** 的联动。([GitHub][18])
* 对你最有价值的不是代码本身，而是控制逻辑：

  * 先液体准备
  * 再按严格时序点胶/转速 ramp
  * 再退让/转运/后处理
  * 再把样品、参数、结果绑定成一次 run
* 这正好对应你未来“旋涂 + 移液 + 三轴 + 记录”的系统目标。([GitHub][18])

**你应该抄什么**

* run / sample / job 的数据模型
* 调度与时序约束表达
* 参数扫描与实验记录组织
* 旋涂前后设备协作顺序

---

### Layer 4 推荐 2：**Maasi**

**为什么推荐**

* 它是少数真正公开了**整机旋涂器设计**的开源项目。
* 对你可借鉴的重点是：

  * 转速 ramp 的 UI/参数组织
  * 低成本旋涂器的人机交互
  * 安全外罩、盖板、持片设计等整机经验([GitHub][4])

**为什么不是主路线**

* 项目作者自己都写了 **no longer actively maintained**。([GitHub][4])
* 它更像“独立旋涂机”，不是“带三轴与夹爪的平台子模块”。

---

### Layer 5 推荐 1：**Node-RED**

**为什么推荐**

* 很适合做你这种“树莓派本地运行、多个设备协议、有状态流程、还要给手机/平板一个可视化页面”的系统。
* 串口、HTTP、MQTT、数据库节点成熟，流程图对排查实验流程特别友好。
* 非程序员/未来同事也更容易看懂流程。([GitHub][5])

**适合放什么**

* recipe 编排
* 报警/通知
* run 开始/暂停/急停工作流
* 简单 dashboard

**不适合放什么**

* 复杂设备驱动细节
* 需要强类型和单元测试的业务逻辑

---

### Layer 5 推荐 2：**Streamlit + SQLite**

**为什么推荐**

* 你“软件不差”，那 Streamlit 会很舒服：
  一边写 Python orchestrator，一边直接把参数页、run 历史、图表、报警列表做出来。
* 对实验场景，比 Gradio 更像“内部工具”。([GitHub][19])

**最适合你的用法**

* 首页：设备状态 / homed / alarm / interlock
* 配方页：速度曲线、点胶时序、夹爪参数
* 运行页：step log / current phase / abort
* 历史页：SQLite 查询、导出 CSV

---

## 3) 整体迁移建议：最小风险路径

### 第 0 步：先补安全硬件，不动软件大框架

先做两件事：

* **急停硬件链路**：E-stop 直接切 driver ENA / 电源接触器，不依赖 MCU。
* **Z 轴刹车联锁**：上电/失电/报警/急停时的默认策略先定清楚。

**rollback**：不涉及现有系统逻辑，无需回滚。

---

### 第 1 步：只替换 Layer 1，前端暂时不动

把 `motor_control.ino` 换成 `grbl-Mega-5X`，但你现有网页先只做最小改造：
前端不再发私有命令，而是发 G-code / GRBL system command。

**目标**

* 验证步进平滑性
* 验证 acceleration / deceleration
* 验证 homing / hard limit / soft limit
* 验证 hold / resume / alarm

**rollback**

* 保留原 `motor_control.ino` 固件和接线定义
* 同一套 Mega 直接刷回旧固件即可

---

### 第 2 步：引入 Layer 2（cncjs），废弃 Web Serial 直连

在树莓派跑 cncjs，让浏览器/手机不再直接连 Arduino，而是连树莓派。

**目标**

* sender、状态显示、queue、macro、Web UI 全交给成熟项目
* 降低你前端自研负担
* 为 MCP/API 网关做中间层

**rollback**

* 前端仍可临时直连旧网页
* 固件不需要回滚

---

### 第 3 步：搭一个很薄的 Python orchestrator

只做 4 个对象：

* Motion
* Gripper
* Spin
* RunLog

先不要碰 PyLabRobot / ROS 2 / ChemOS。

**目标**

* 统一串口/RS485 生命周期
* 统一 run_id / step_id / log schema
* 统一 homed / alarm / busy / estop 状态机

**rollback**

* orchestrator 只是旁路服务
* 失败时可直接用 cncjs 手动控制运动层

---

### 第 4 步：再接入旋涂模块和移液模块

这时 motion 层已经稳定，不要反过来把所有变量一次性叠上。

**目标**

* 先实现单次 recipe：
  `取片 -> 放片 -> 点胶 -> 旋涂曲线 -> 取片 -> 记录`
* 再实现参数扫描 / 批处理

**rollback**

* 模块未稳定时，保持运动层和夹爪层独立可手动操作

---

### 第 5 步：最后才做漂亮 UI 和高级编排

在 Node-RED 与 Streamlit 二选一：

* 偏流程/多人协作：Node-RED
* 偏工程化/代码维护：Streamlit

我的偏向：**主控逻辑 Python + Streamlit，报警/外部触发可选 Node-RED 辅助。**

---

## 4) 反向意见：什么情况下继续自研更合理？

这里我不想为了“用开源”而用开源。

### 继续自研更合理的层

#### Layer 3：多模块协调层

这层我认为**继续自研反而更合理**。

原因很简单：
你有 **三轴平台 + 力控夹爪 + 未来旋涂模块 + 未来移液模块 + 实验记录**，而且是单机、DIY、非标准设备组合。
现成框架要么太大，要么抽象不贴，要么你最后还是得写一圈 adapter。

所以这层最合理的是：

* **借鉴开源**
* **用成熟库**
* **自己写薄编排层**

而不是硬上 ChemOS/ROS 2。([GitHub][20])

#### Layer 4：旋涂工艺参数逻辑

“转速曲线 + 加速度 + 点胶时序 + 持片/放片节拍”
这部分高度依赖你的材料、液体体系、夹具、转盘惯量、滴液方式。

这层**没有一个通吃的开源答案**。
你应该借鉴 PASCAL / Maasi 的思路，但**工艺 recipe 本身还是你自己沉淀最值钱**。([GitHub][18])

---

## 我的最终建议

### 最推荐组合

* **Layer 1**：`grbl-Mega-5X`
* **Layer 2**：`cncjs`
* **Layer 3**：自研 Python orchestrator

  * `asyncio`
  * `pyserial-asyncio`
  * `pymodbus`
  * `sqlite`
* **Layer 4**：借鉴 `PASCAL` 的调度与 run 数据模型
* **Layer 5**：`Streamlit` 主 UI，必要时 `Node-RED` 做流程编排/通知

### 不推荐现在投入的方向

* 在 Mega 上继续深挖你那套私有串口协议
* 现在就上 ROS 2 / MoveIt
* 为了“最新”而重构到 FluidNC / ESP32
* 直接把 Home Assistant 当主控内核

因为对你来说，**真正的最小风险收益点**是先把“运动控制内核”和“sender/UI”交给成熟项目，把自己的时间留给真正还没人替你解决的部分：
**多模块协同、实验流程安全、工艺参数沉淀、数据闭环。**

你要是愿意，我下一条可以直接继续给你一版更落地的东西：
**“基于 grbl-Mega-5X + cncjs + Python orchestrator 的具体系统架构图 + 接线/软件模块清单 + 2 周迁移计划表”。**

[1]: https://github.com/fra589/grbl-mega-5x "GitHub - fra589/grbl-Mega-5X: 5/6 Axis version of Grbl, the open source, embedded, high performance g-code-parser and CNC milling controller written in optimized C that will run on an Arduino Mega2560 · GitHub"
[2]: https://github.com/cncjs/cncjs "GitHub - cncjs/cncjs: A web-based interface for CNC milling controller running Grbl, Marlin, Smoothieware, or TinyG. · GitHub"
[3]: https://github.com/PyLabRobot/pylabrobot "GitHub - PyLabRobot/pylabrobot: interactive & hardware agnostic SDK for lab automation · GitHub"
[4]: https://github.com/klotzsch-lab/Maasi?utm_source=chatgpt.com "klotzsch-lab/Maasi - Open source spin coater"
[5]: https://github.com/node-red/node-red "GitHub - node-red/node-red: Low-code programming for event-driven applications · GitHub"
[6]: https://github.com/fra589/grbl-mega-5x?utm_source=chatgpt.com "fra589/grbl-Mega-5X: 5/6 Axis version ..."
[7]: https://github.com/fra589/grbl-Mega-5X/discussions/281?utm_source=chatgpt.com "negative soft limits · fra589 grbl-Mega-5X · Discussion #281"
[8]: https://github.com/gnea/grbl-Mega/blob/edge/doc/markdown/commands.md?utm_source=chatgpt.com "grbl-Mega/doc/markdown/commands.md at edge"
[9]: https://github.com/marlinfirmware/marlin "GitHub - MarlinFirmware/Marlin: Marlin is a firmware for RepRap 3D printers optimized for both 8 and 32 bit microcontrollers.  Marlin supports all common platforms.   Many commercial 3D printers come with Marlin installed.  Check with your vendor if you need source code for your specific machine. · GitHub"
[10]: https://marlinfw.org/docs/gcode/M211.html?utm_source=chatgpt.com "M211: Software Endstops"
[11]: https://github.com/cncjs/cncjs/issues/789?utm_source=chatgpt.com "[Question] How do we send commands to CNCJS through ..."
[12]: https://github.com/cncjs/cncjs/wiki/_history?utm_source=chatgpt.com "History · cncjs Wiki"
[13]: https://github.com/cncjs/cncjs-controller?utm_source=chatgpt.com "cncjs/cncjs-controller: A controller library for event-based ..."
[14]: https://www.reddit.com/r/hobbycnc/comments/18n3ez5/universal_gcode_sender_and_triggering_macros/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 "Universal Gcode Sender and triggering macros remotely"
[15]: https://github.com/winder/Universal-G-Code-Sender "GitHub - winder/Universal-G-Code-Sender: A cross-platform G-Code sender for GRBL, Smoothieware, TinyG and G2core. · GitHub"
[16]: https://github.com/pymodbus-dev/pymodbus?utm_source=chatgpt.com "PyModbus - A Python Modbus Stack"
[17]: https://github.com/pyserial/pyserial-asyncio "GitHub - pyserial/pyserial-asyncio: asyncio extension package for pyserial · GitHub"
[18]: https://github.com/fenning-research-group/PASCAL?utm_source=chatgpt.com "fenning-research-group/PASCAL: Codebase to drive the ..."
[19]: https://github.com/streamlit/streamlit "GitHub - streamlit/streamlit: Streamlit — A faster way to build and share data apps. · GitHub"
[20]: https://github.com/aspuru-guzik-group/ChemOS?utm_source=chatgpt.com "aspuru-guzik-group/ChemOS"
