weng1259/autospin/hardware/龙门架/驱动器/闭环设置.md

这是一个根据您提供的图片提取的细分设置（Pulse/rev Table）以及其他拨码开关设置的文本：

### Pulse/rev Table (细分设置)

| Pulse/rev | Sw3 | Sw4 | Sw5 | Sw6 |
| :--- | :--- | :--- | :--- | :--- |
| **Default** | on | on | on | on |
| **800** | off | on | on | on |
| **1600** | on | off | on | on |
| **3200** | off | off | on | on |
| **6400** | on | on | off | on |
| **12800** | off | on | off | on |
| **25600** | on | off | off | on |
| **51200** | off | off | off | on |
| **1000** | on | on | on | off |
| **2000** | off | on | on | off |
| **4000** | on | off | on | off |
| **5000** | off | off | on | off |
| **8000** | on | on | off | off |
| **10000** | off | on | off | off |
| **20000** | on | off | off | off |
| **40000** | off | off | off | off |

---

### 其他拨码开关设置 (Sw1, Sw2, Sw7, Sw8)

* **Sw1: 闭环模式 (Close Loop Mode)**
    * `off` = 功率角模式
    * `on` = 矢量模式
* **Sw2: 旋转方向 (Motor DIR)**
    * `off` = CCW (逆时针)
pen/Close Loop)**
    * `off` = Close Loop (闭环)
    * `on` = Open Loop (开环)

需要我为您解释这些参数的具体含义或提供其他关于此驱动器的帮助吗？
