weng1259/autospin/docs/开源方案调研-prompt.md

# 开源方案调研任务（给调研 AI 的提示词）

复制下面整段发给你用的 AI（建议用有联网搜索能力的模型，如 ChatGPT with Search / Perplexity / Claude with Web Search）。

---
