weng1259/autospin/_report_archive/LEGACY_REMOVAL_REHEARSAL_REPORT.md

# Legacy `autospin_system` Removal Rehearsal Report

Date: 2026-08-05  
Rehearsal type: disposable filesystem checkout  
Main working-tree deletion: **not performed**

## 1. Scope and authority

The rehearsal tested whether the maintained project operates when
`autospin_system/` is completely absent.

`autospin_system` was not inspected or used as a behavior source. No logic,
tests, actions, protocols, scheduler behavior, or hardware semantics were
migrated from it. The sole authoritative legacy behavior source remains the
separate `AutoSpinmotorSystem` project.

No changes were made to `ActionExecutor`, scheduling, workflows, or experiment
behavior during this rehearsal.

## 2. Isolated removal-test environment

A disposable copy of the current working tree was created at:

```text
C:\Users\16935\AppData\Local\Temp\autospin-removal-rehearsal-20260805-01
```

The copy excluded:

- `autospin_system/`;
- `.git/`;
- `.venv/`;
- Python, pytest, and mypy caches;
- `runtime/`;
- `migration_snapshot/`;
- generated bytecode and the existing Streamlit log.

The environment check returned:

```text
LEGACY_PRESENT=False
```

The main working tree's `autospin_system/` directory was neither moved, hidden,
modified, nor deleted.

## 3. Tests executed

### 3.1 Maintained test suite

Command, executed from the isolated copy:

```text
D:\python\python3.11.0\python.exe -m pytest -q
```

Result:

```text
468 passed, 1 skipped, 1 warning
```

The warning is the existing Starlette `TestClient` deprecation warning. Pytest
did not collect any path containing `autospin_system`.

### 3.2 Web application startup

The actual Uvicorn entry point was started from the isolated copy:

```text
python tools/run_webserver.py --mock --host 127.0.0.1 --port 18800
```

The public health endpoint returned:

```text
HTTP 200
{"ok":true,"version":"1.0","mock":true}
```

Uvicorn reported application startup complete. The rehearsal then explicitly
stopped the temporary Web process.

### 3.3 `DeviceRegistry.from_config()`

The configured registry was constructed without connecting to or actuating
hardware.

```text
REGISTRY_FROM_CONFIG=PASS
REGISTRY_MOCK=False
gantry=True
relay=True
gripper=True
spincoater=True
heater=True
pipette=True
linear_stage=True
```

Registry shutdown completed in the isolated process.

### 3.4 Protocol generation

Three maintained perovskite protocols were generated through
`src.protocol.create_perovskite_protocol`.

```text
PROTOCOL_GENERATION=PASS
PROTOCOL_COUNT=3
PROTOCOL_OPERATIONS=[5, 5, 5]
```

No protocol or template was loaded from the obsolete directory.

### 3.5 Single-experiment dry run

The maintained `perovskite_basic` template was executed through
`ExperimentService` and a mock `DeviceRegistry`.

```text
success=true
actions=18
error=null
```

### 3.6 Multi-round dry run

The three generated protocols were compiled through `compile_multi_round` and
executed as one action plan through `ExperimentService.execute_plan`.

```text
success=true
rounds=3
actions=63
error=null
```

### 3.7 Runtime module audit

After Web/registry/protocol/experiment imports and dry runs:

```text
LOADED_LEGACY_MODULES=[]
EXECUTABLE_IMPORT_REFERENCES=0
```

No executable Python import of `autospin_system` was found outside the omitted
directory.

## 4. Runtime-path search result

The maintained runtime source, tools, configuration, deployment scripts,
firmware, hardware assets, and Web control paths were searched.

No active Python module, startup entry point, pytest configuration, or deployed
udev command depends on `autospin_system`.

One ignored historical backup file remains in the main tree and was copied into
the rehearsal environment:

```text
tools/ui/emergency_dashboard.py.bak.20260629
```

It contains three obsolete import statements. The `.bak.20260629` suffix means
Python does not import it as a module, pytest does not collect it, no maintained
command references it, and the Web startup did not load it. It is therefore not
an executable dependency, but it is a cleanup blocker because it can confuse
future repository searches or be manually renamed/executed. It should be
archived outside the application tree or removed as one explicit file before
final legacy deletion.

Intentional non-runtime textual references remain in retirement reports,
change history, the hardware acceptance prohibition, and a negative dependency
test. They document or prevent use of the obsolete package rather than depend
on it.

## 5. Raspberry Pi deployment assumptions

### 5.1 Startup command

The maintained documented startup command is:

```text
cd /home/pi/autospin
python3 tools/run_webserver.py --host 127.0.0.1 --port 8800
```

`tools/run_webserver.py` imports `src.webapp`, creates exactly one
`DeviceRegistry`, and contains no obsolete-package import. The same entry point
started successfully in this rehearsal.

### 5.2 Python import path

- `tools/run_webserver.py` inserts its repository root into `sys.path`.
- `pytest.ini` uses `pythonpath = .` and `testpaths = tests`.
- No repository startup documentation requires the obsolete directory on
  `PYTHONPATH`.
- The local host's external `PYTHONPATH` points to ChemOffice and played no role
  in loading this project.

The Raspberry Pi's actual service environment has not been queried. Before
deletion, verify it with commands such as:

```bash
systemctl cat <actual-autospin-service>
systemctl show <actual-autospin-service> -p Environment -p EnvironmentFiles -p WorkingDirectory -p ExecStart
tr '\0' '\n' </proc/<autospin-pid>/environ | grep -E '^(PYTHONPATH|PATH)='
tr '\0' ' ' </proc/<autospin-pid>/cmdline
```

The real service name must be obtained on the Pi rather than guessed.

### 5.3 systemd service

Repository audit result:

```text
SYSTEMD_UNIT_COUNT=0
```

No `.service`, `.timer`, or `.socket` file is versioned under this repository.
`Migration record/RASPBERRY_PI_SYNC_REPORT.md` also states that existing Pi
systemd definitions and environment variables were not included in the prior
deployment selection. Consequently, the local rehearsal cannot prove that an
already-installed Pi unit does not invoke or expose `autospin_system`.

This is the principal deployment-side blocker.

### 5.4 udev documentation

`deploy/udev/README.md` now:

- points to `config/hardware.yaml` and `config/devices.yaml`;
- uses maintained tests under `tests/`;
- uses the registry-backed read-only wiring smoke;
- contains no `autospin_system` reference.

Udev rules only create stable serial names and do not select a Python package.

## 6. Failures and observations

### Required rehearsal failures

None. Every required software test passed without the obsolete directory.

### Non-blocking warning

- Existing Starlette `TestClient` deprecation warning during pytest.

### Cleanup/deployment observations

- Ignored backup `tools/ui/emergency_dashboard.py.bak.20260629` still contains
  dormant obsolete imports.
- Raspberry Pi systemd unit and process environment are not stored in the
  repository and could not be verified locally.
- Raspberry Pi hardware smoke tests were deliberately not run; this rehearsal
  did not connect to real hardware.

## 7. Remaining blockers

Before deleting `autospin_system/` from the main repository/deployment:

1. archive outside the application tree or explicitly remove
   `tools/ui/emergency_dashboard.py.bak.20260629`;
2. inspect the actual Raspberry Pi systemd unit, `ExecStart`, working directory,
   environment files, process command line, and `PYTHONPATH`;
3. confirm the deployed source/config hashes correspond to the rehearsed code;
4. run the maintained read-only `DeviceRegistry` wiring smoke on the Pi;
5. repeat Web health, registry construction, and dry-run checks on the Pi with
   the obsolete directory absent or inaccessible;
6. preserve an approved source-control tag or external checksum archive;
7. perform deletion as a standalone reviewed change without experiment or
   hardware behavior modifications.

## 8. Is deletion safe?

### Software/code conclusion

**Yes.** The local maintained project, tests, Web service, configured registry,
protocol generation, single dry run, and multi-round dry run all operate with
`autospin_system/` absent. No executable dependency remains in the rehearsed
codebase.

### Production deployment conclusion

**Not yet unconditionally approved.** The source-code dependency risk is
cleared, but actual Raspberry Pi systemd and environment settings remain
unverified, and one dormant ignored backup should be removed from the
application tree. Until those deployment checks pass, deletion from the live Pi
should be treated as conditionally safe rather than fully released.

The main working-tree directory remains untouched after this rehearsal.
