weng1259/autospin/hardware/参考/写字机图片/photo_2026-03-21_00-05-48.jpg

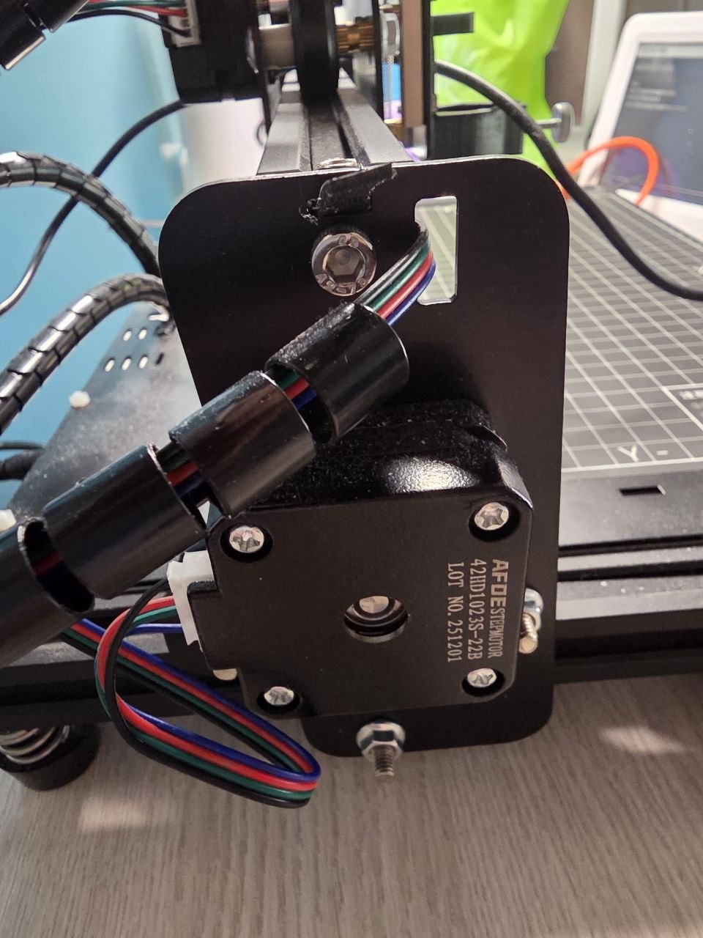
hardware/参考/写字机图片/photo_2026-03-21_00-05-48.jpg
