weng1259/autospin/hardware/参考/测试记录/photo_2026-03-23_16-41-58.jpg

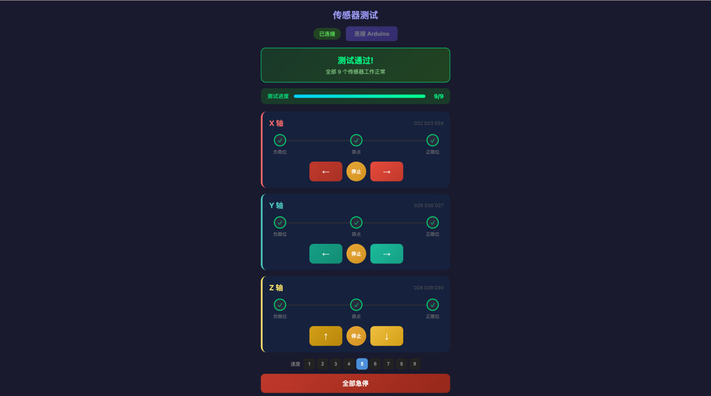
hardware/参考/测试记录/photo_2026-03-23_16-41-58.jpg
