weng1259/autospin/hardware/夹爪/photos/photo_2026-03-23_16-17-49.jpg

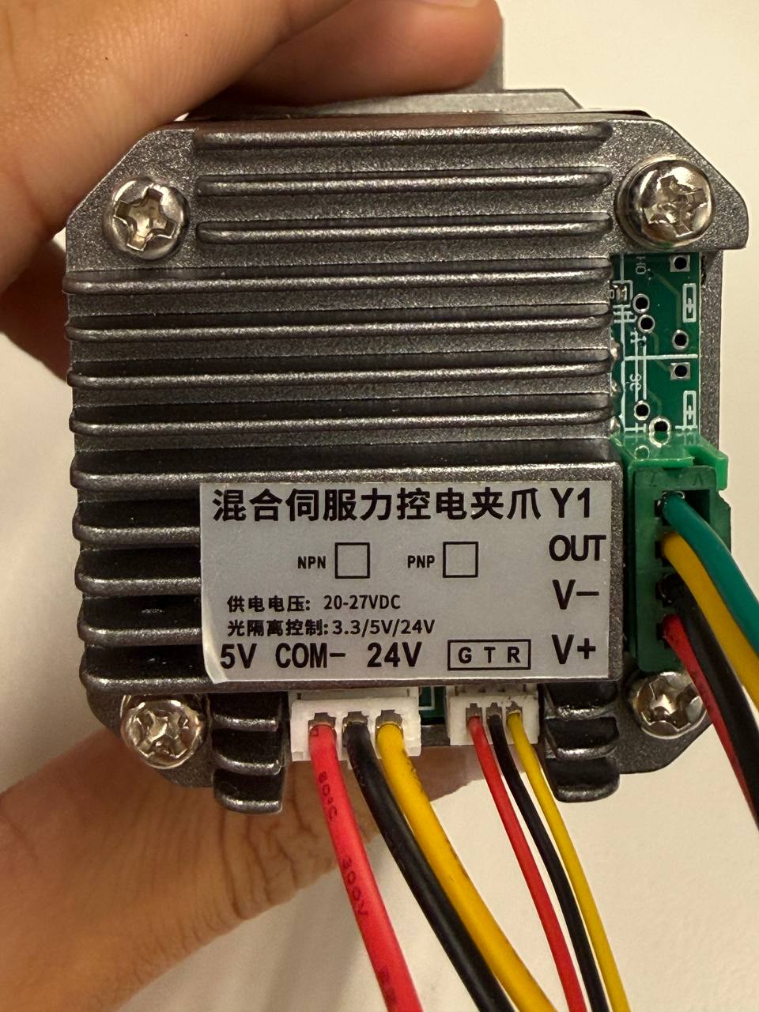
hardware/夹爪/photos/photo_2026-03-23_16-17-49.jpg
