weng1259/autospin/hardware/夹爪/photos/photo_2026-03-23_17-38-33.jpg

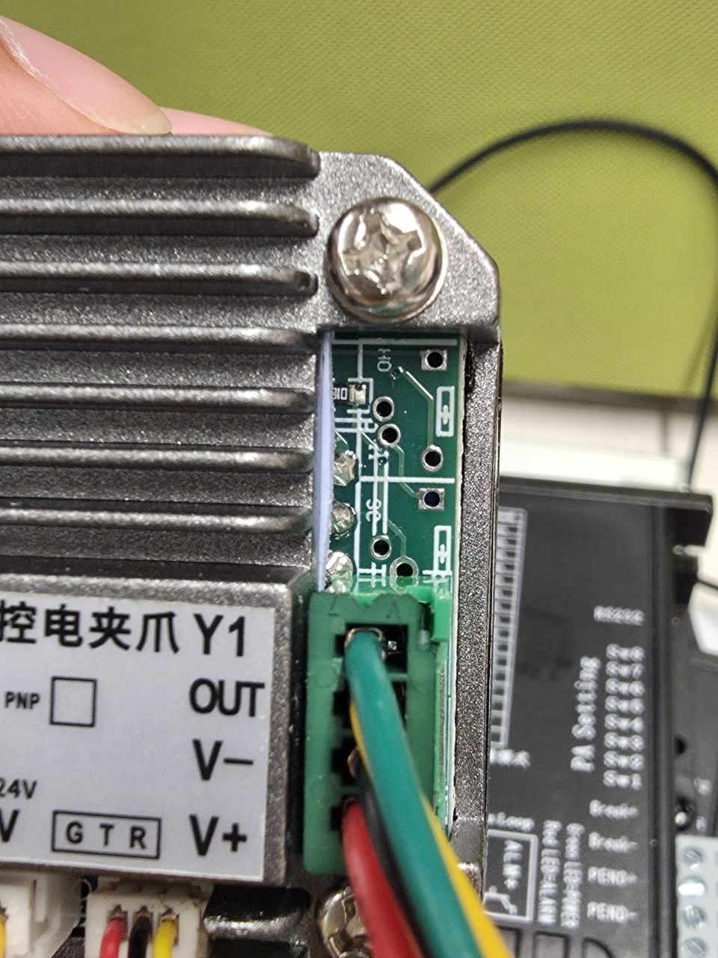
hardware/夹爪/photos/photo_2026-03-23_17-38-33.jpg
