weng1259/autospin/hardware/继电器/photos/photo_2026-03-09_23-12-59.jpg

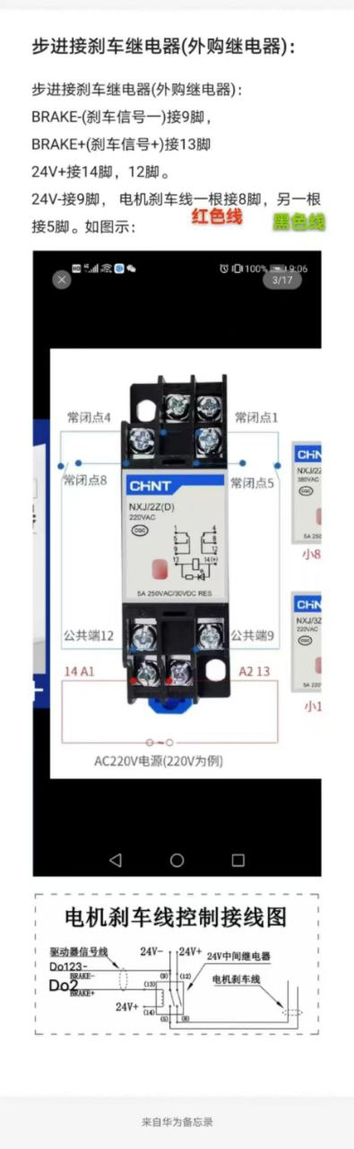
hardware/继电器/photos/photo_2026-03-09_23-12-59.jpg
