weng1259/autospin/hardware/继电器/photos/photo_2026-03-21_01-24-17.jpg

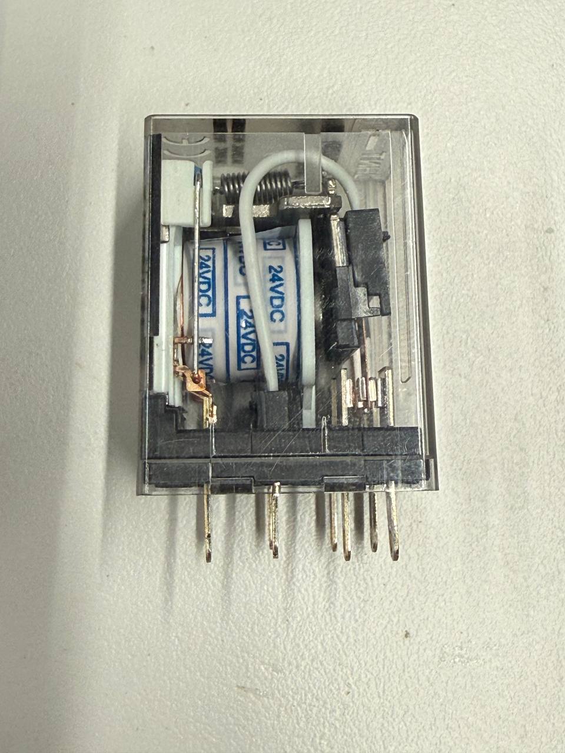
hardware/继电器/photos/photo_2026-03-21_01-24-17.jpg
