weng1259/autospin/hardware/继电器/photos/photo_2026-03-23_19-20-16.jpg

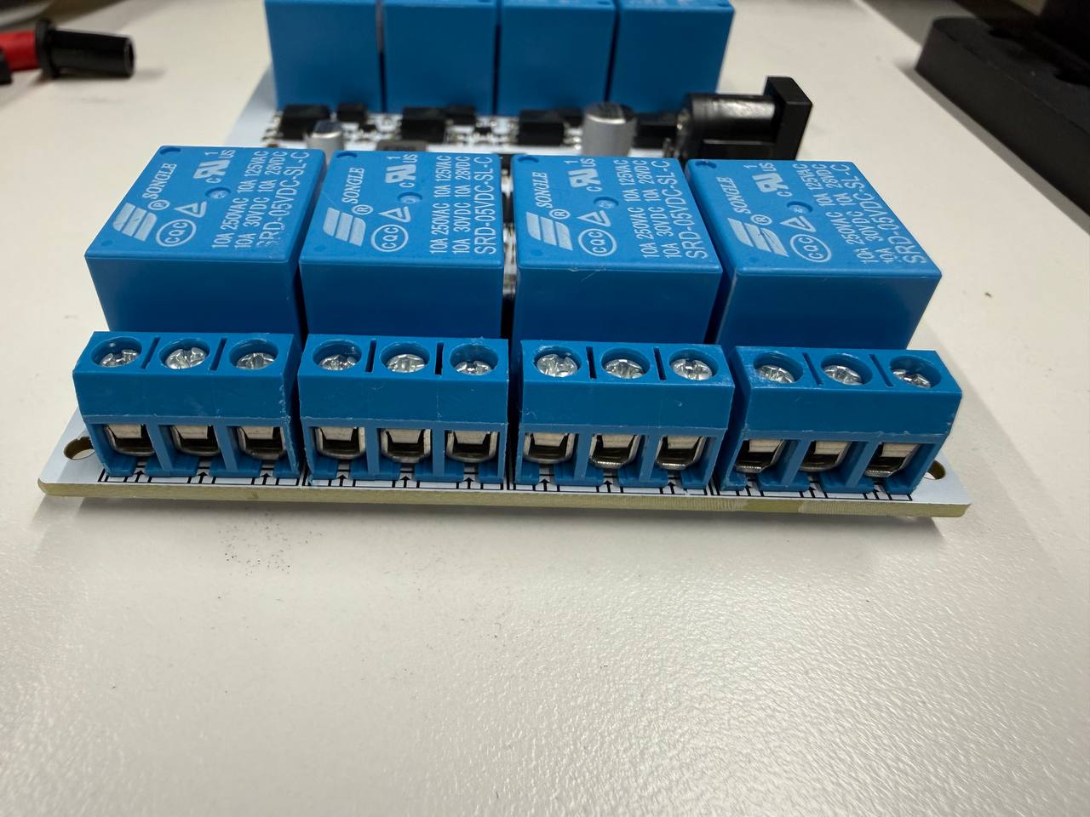
hardware/继电器/photos/photo_2026-03-23_19-20-16.jpg
