weng1259/autospin/hardware/龙门架/photos/Arduino/photo_2026-03-16_16-14-22.jpg

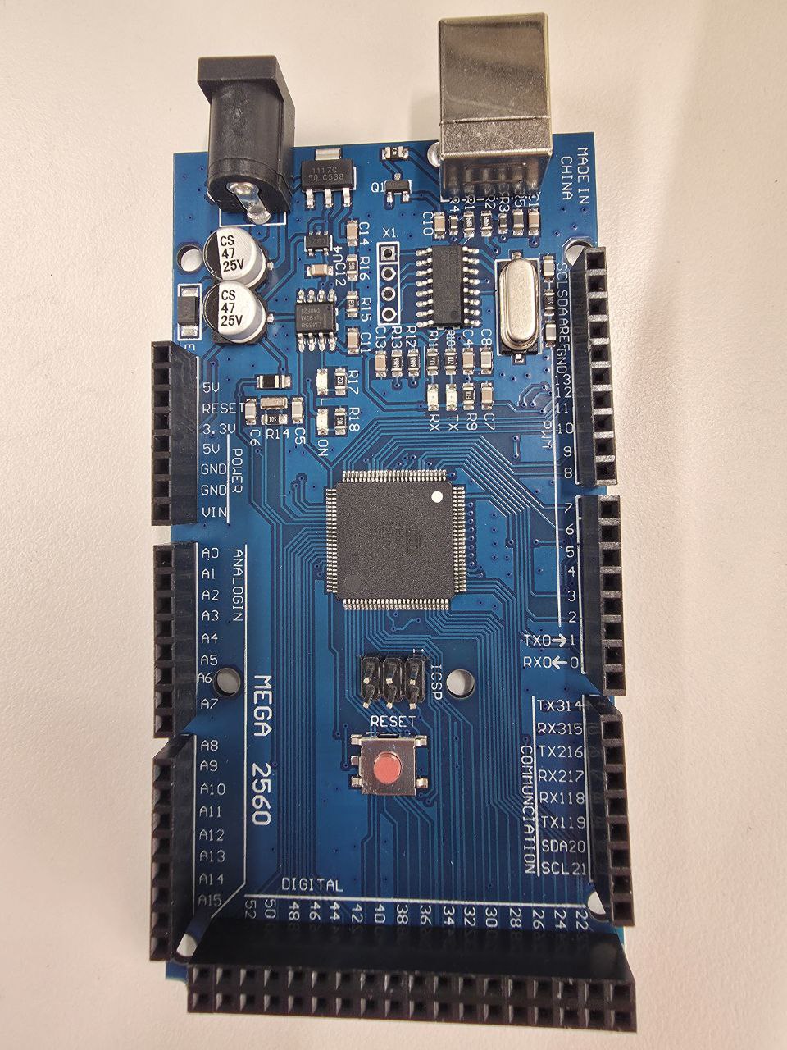
hardware/龙门架/photos/Arduino/photo_2026-03-16_16-14-22.jpg
