weng1259/autospin/hardware/龙门架/photos/传感器/photo_2026-03-09_23-25-41.jpg

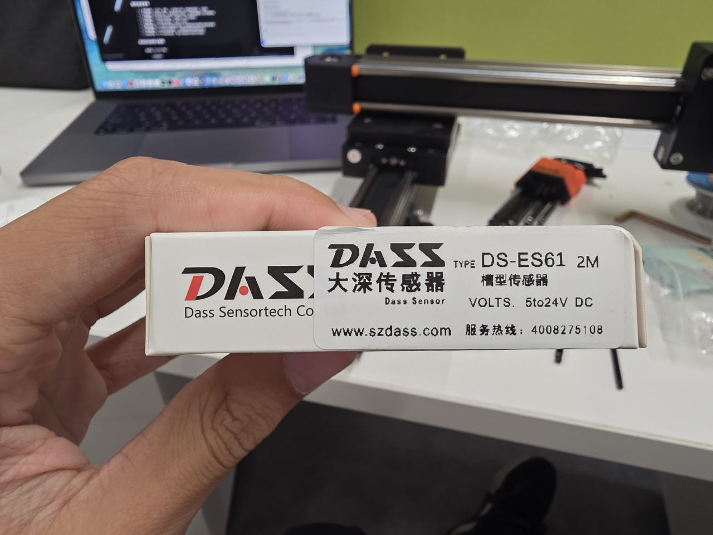
hardware/龙门架/photos/传感器/photo_2026-03-09_23-25-41.jpg
