weng1259/autospin/hardware/龙门架/photos/传感器/photo_2026-03-10_20-38-10.jpg

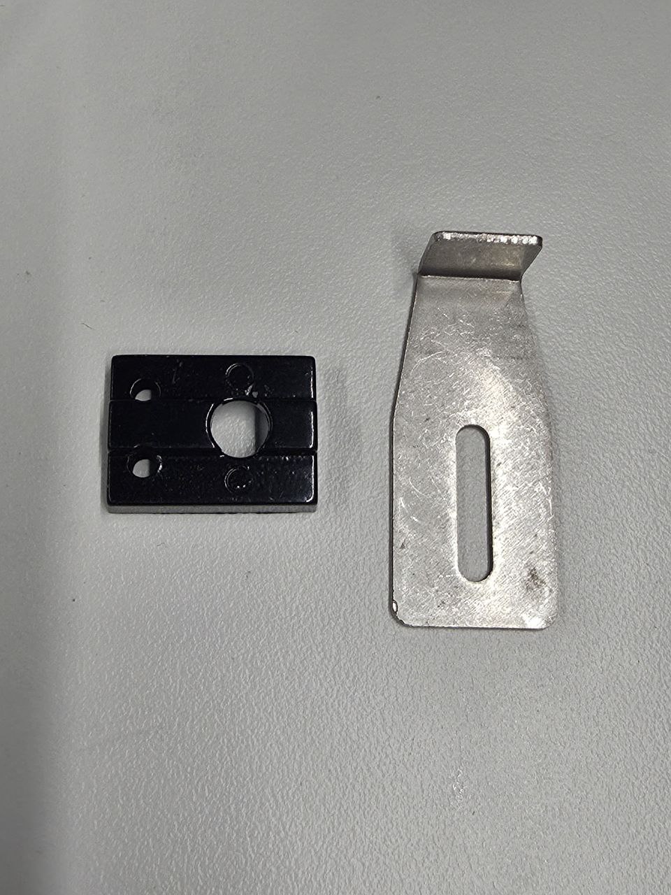
hardware/龙门架/photos/传感器/photo_2026-03-10_20-38-10.jpg
