weng1259/autospin/hardware/龙门架/photos/安装/photo_2026-03-20_16-00-14.jpg

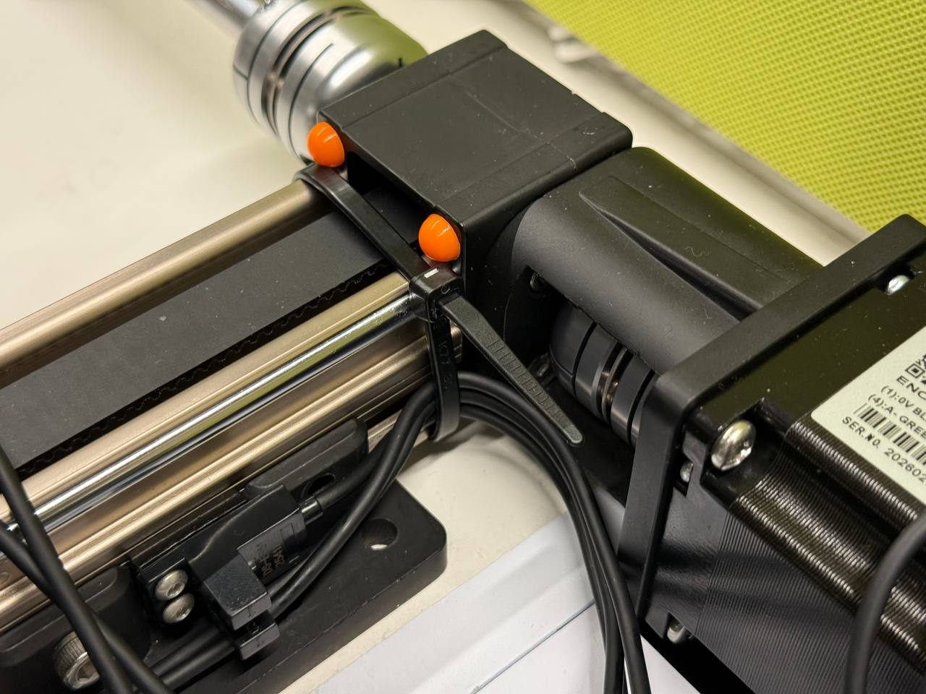
hardware/龙门架/photos/安装/photo_2026-03-20_16-00-14.jpg
