weng1259/autospin/hardware/龙门架/photos/电机/photo_2026-03-09_23-25-47.jpg

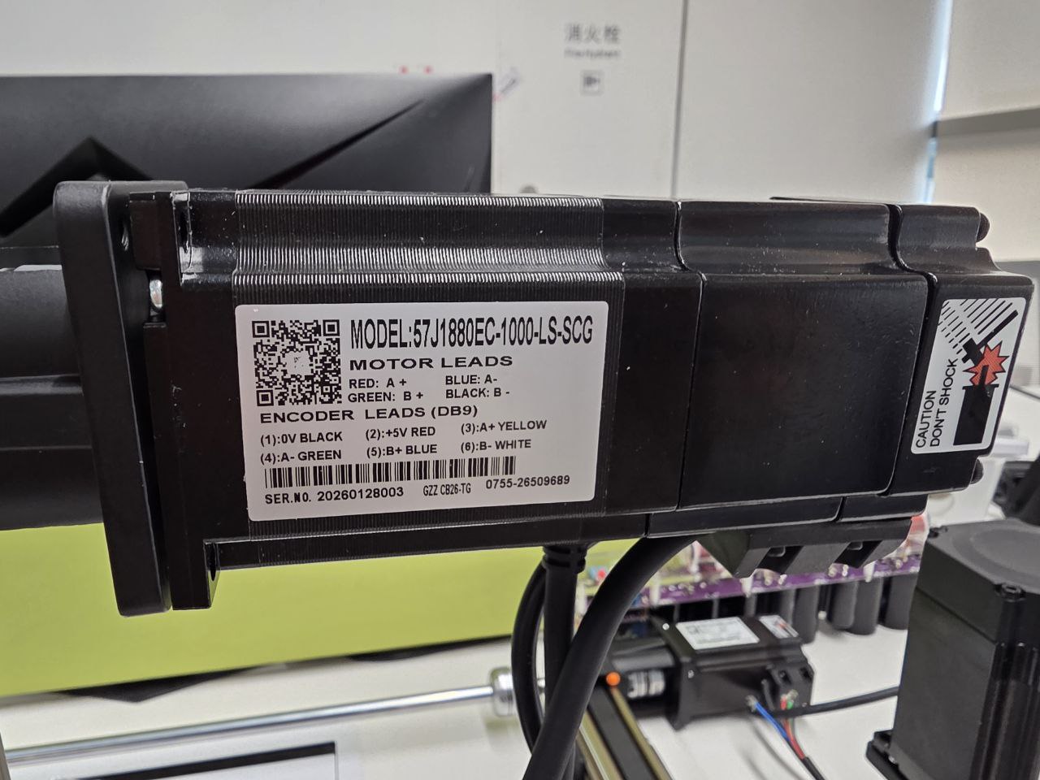
hardware/龙门架/photos/电机/photo_2026-03-09_23-25-47.jpg
