weng1259/autospin/hardware/龙门架/photos/电机/photo_2026-03-17_18-39-57.jpg

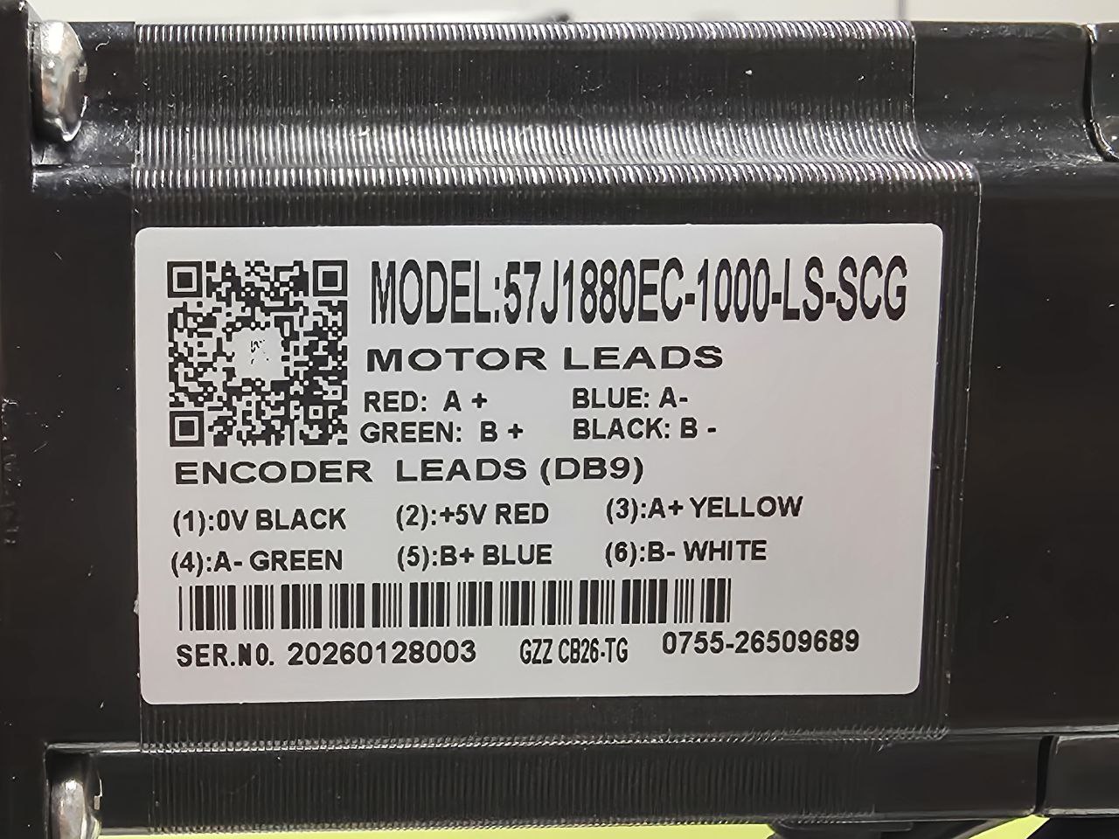
hardware/龙门架/photos/电机/photo_2026-03-17_18-39-57.jpg
