weng1259/autospin/hardware/龙门架/photos/电源/photo_2026-03-16_16-14-35.jpg

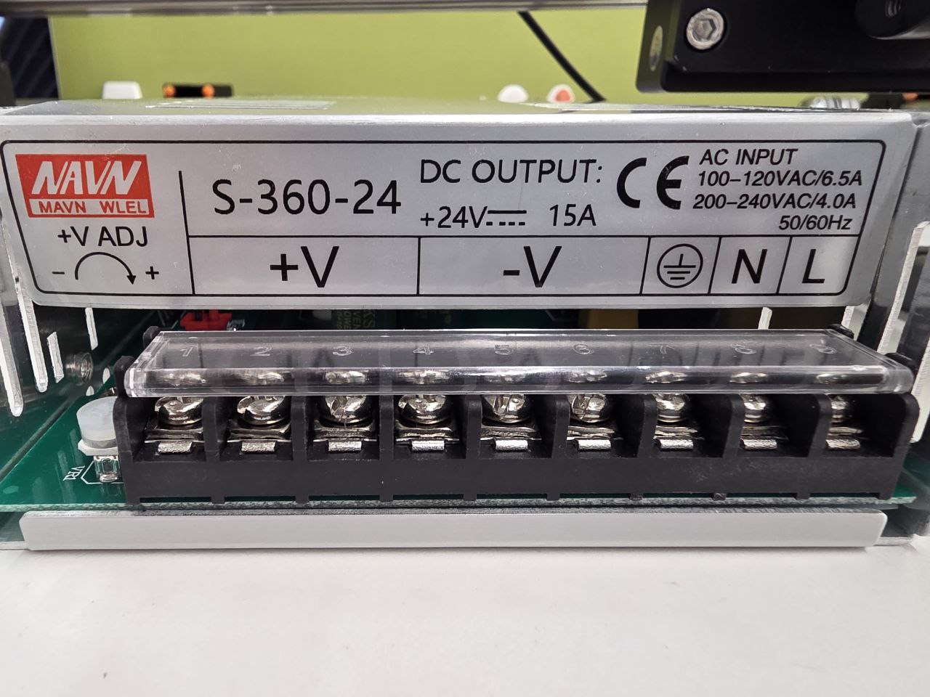
hardware/龙门架/photos/电源/photo_2026-03-16_16-14-35.jpg
