weng1259/autospin/hardware/龙门架/photos/驱动器/photo_2026-03-09_23-25-35.jpg

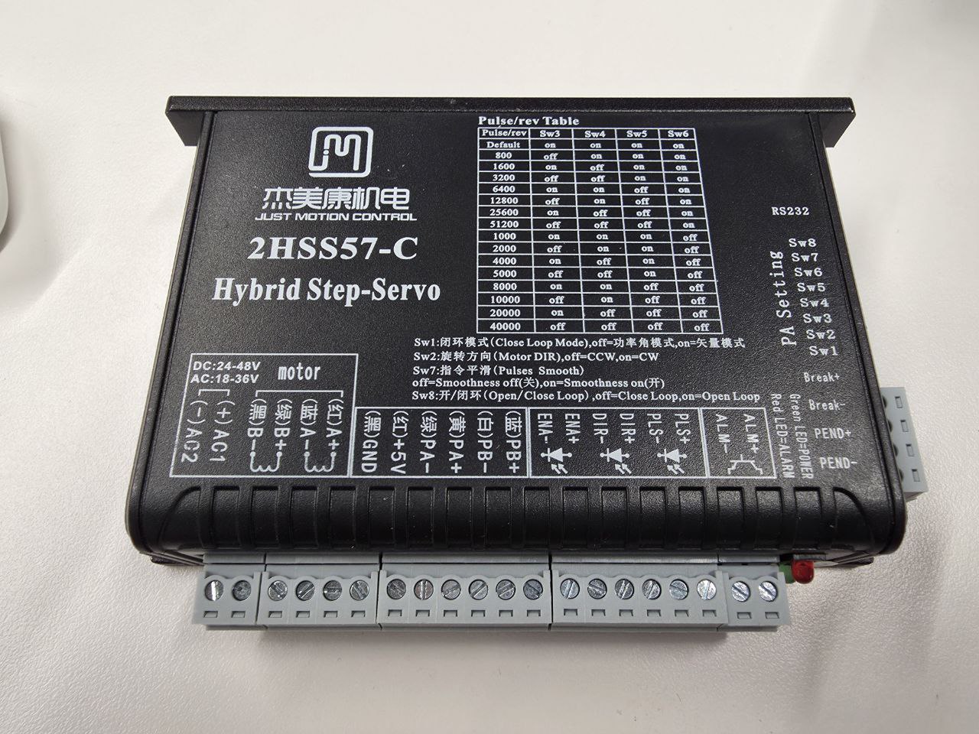
hardware/龙门架/photos/驱动器/photo_2026-03-09_23-25-35.jpg
