weng1259/autospin/hardware/龙门架/photos/驱动器/photo_2026-03-16_16-14-28.jpg

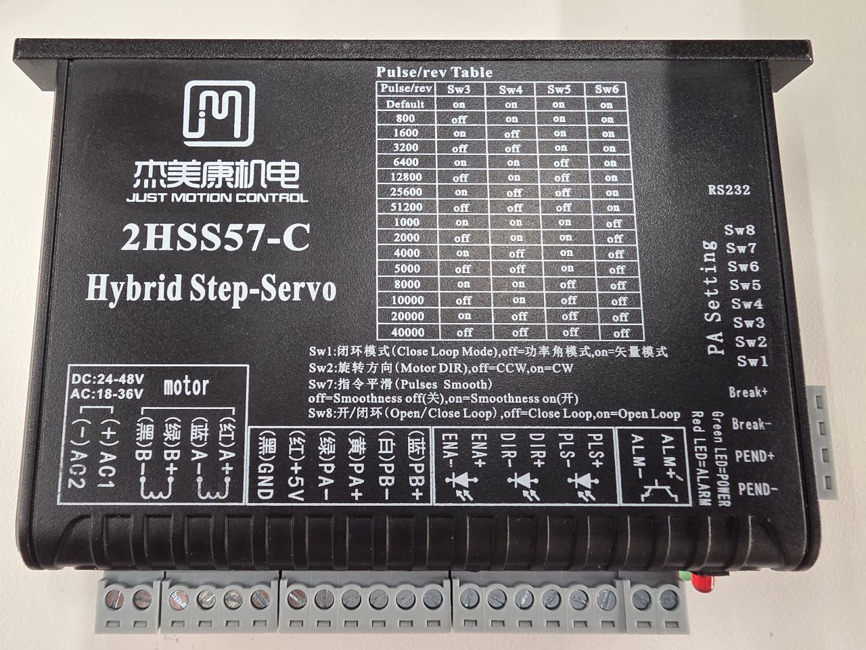
hardware/龙门架/photos/驱动器/photo_2026-03-16_16-14-28.jpg
