weng1259/autospin/hardware/采购清单.md

# 智能旋涂仪 — 采购清单

> 基于杰美康 2HSS57-C 驱动器手册、大深 DS-ES61 传感器参数、57J1880EC 电机铭牌确认。

---

## 物料清单

| 名称 | 规格/型号 | 数量 | 用途 | 状态 |
|---|---|---|---|---|
| GH40 龙门架 | GH40-D75-X300S-Y300S-Z100S-57 | 1 | 三轴运动平台 | 已到 |
| 闭环步进电机 | 57J1880EC-1000-LS-SCG | 3 | XYZ轴驱动（Z轴带刹车） | 已到 |
| 步进驱动器 | 杰美康 2HSS57-C | 3 | 电机驱动 | 已到 |
| 槽型光电传感器 | 大深 DS-ES61（5~24V DC） | 9 | 限位/原点检测 | 已到 |
| 24V 15A 开关电源 | MAVN S-360-24 | 1 | 驱动器+继电器统一供电 | 已到 |
| Arduino Mega 2560 | CH340国产版 | 1 | 主控制器 | 已到 |
| 三芯电源线 | 3×1.0mm² 国标三脚插头 散线端 1.5米 | 1 | 电源220V输入 | 已到 |
| 杜邦线 公对母 | 40P | 1 | Arduino接驱动器信号线 | 已到 |
| 剥线钳 | — | 1 | 剥电线皮 | 已到 |
| 小一字螺丝刀 | 3mm | 1 | 拧驱动器接线端子 | 已到 |
| 万用表 | 数字万用表 | 1 | 线路检查排查 | 已到 |
| ~~正泰继电器+底座~~ | ~~NXJ/2Z 24VDC~~ | ~~1~~ | ~~Z轴刹车控制~~ | ~~已淘汰~~ → 被 DSTUR-T80 替代 |
| DSTUR-T80 USB继电器 | 8路 USB串口控制，光耦隔离，SRD-05VDC-SL-C | 1 | 夹爪控制(CH1) + Z轴刹车(CH2)，6路备用 | 已到 |
| DB9免焊接头（母头） | DB9 母头 免焊螺丝端子 | 3 | 编码器转接（切闭环模式） | 已到 |
| 内六角扳手套装 | 公制 1.5~6mm | 1 | 机械紧固 | 已到 |
| 十字螺丝刀 | PH2 | 1 | 备用 | 已到 |
| 螺丝 M4×16 | 内六角不锈钢 | 10 | 固定电机 | 已到 |
| 螺丝 M4×20 | 内六角不锈钢 | 10 | 固定电机备用 | 已到 |
| 螺丝 M5×16 | 内六角不锈钢 | 10 | 固定电机 | 已到 |
| 螺丝 M5×20 | 内六角不锈钢 | 10 | 固定电机备用 | 已到 |
| 电工胶带 | 黑色 | 1 | 绝缘固定 | 已到 |

---

## 不需要买的（已确认）

| 东西 | 为什么不需要 |
|---|---|
| ~~光耦隔离模块~~ | 传感器 DS-ES61 支持5V，可直接接Arduino |
| ~~24V辅助电源~~ | 改用24V 15A一个电源统一供电 |
| ~~LM2596降压模块~~ | Arduino通过USB供电，传感器也可用Arduino 5V |
| ~~电烙铁~~ | 全部螺丝端子连接，不需要焊接 |
| ~~尖嘴钳~~ | 线头直接插端子，不需要弯 |
| ~~钢直尺~~ | 机械已装好，不需要量尺寸 |
| ~~接线端子排~~ | 电源线直接接驱动器端子 |
| ~~热缩管~~ | 不焊接就没有裸露焊点 |

---

## 关键接线速查

### 电机 → 驱动器

**电机相线**（粗线4根）→ 驱动器功率端口
| 线色 | 端子 |
|---|---|
| 红 | A+ |
| 蓝 | A- |
| 绿 | B+ |
| 黑 | B- |

**编码器线**（DB9散线6根）→ 驱动器编码器端口
| 线色 | 端子 |
|---|---|
| 黑 | GND |
| 红 | VCC(+5V) |
| 黄 | PA+ |
| 绿 | PA- |
| 蓝 | PB+ |
| 白 | PB- |

### 电源 → 驱动器

```
24V电源(+) → 红色线 → 3个驱动器的 VCC（并联）
24V电源(-) → 黑色线 → 3个驱动器的 GND（并联）
```

### Arduino → 驱动器（共阳极，脉冲/方向控制）

```
Arduino 5V → 所有驱动器 PLS+ 和 DIR+（红杜邦线，并联）
Arduino D2 → X轴 PLS-（蓝杜邦线）
Arduino D3 → X轴 DIR-（蓝杜邦线）
Arduino D4 → Y轴 PLS-（绿杜邦线）
Arduino D5 → Y轴 DIR-（绿杜邦线）
Arduino D6 → Z轴 PLS-（紫杜邦线）
Arduino D7 → Z轴 DIR-（紫杜邦线）
ENA+/ENA-  → 悬空不接
```

### 传感器 → Arduino（5V直连，无需转接）

```
棕色线 → Arduino 5V（9个并联）
蓝色线 → Arduino GND（9个并联）
白色线 → Arduino数字引脚（每个1根）：
  X轴：D22(负限位) D23(原点) D24(正限位)
  Y轴：D25(负限位) D26(原点) D27(正限位)
  Z轴：D28(负限位) D29(原点) D30(正限位)
```

### Z轴刹车 → DSTUR-T80 USB继电器 CH2

```
24V电源 +V    → 继电器第2路 COM
继电器第2路 NO → 电机刹车红线
电机刹车黑线   → 24V电源 -V
```

> **原理**：CH2 打开时，COM-NO 导通，24V 经过电机刹车线圈，刹车释放。
> CH2 关闭时，COM-NO 断开，刹车断电锁死（断电抱死，防Z轴下滑）。

### 夹爪 → DSTUR-T80 USB继电器 CH1

```
24V电源 +V    → 继电器第1路 COM
继电器第1路 NO → 夹爪控制器 24V控制引脚
夹爪控制器 COM- → 24V电源 -V
夹爪控制器 V+/V-（绿色端子）→ 24V电源（电机供电，常接）
```

> **原理**：CH1 打开时，24V 接通夹爪控制引脚，夹爪夹合。
> CH1 关闭时，24V 断开，夹爪松开。
> 夹爪电机供电（绿色端子 V+/V-）始终接着24V，不经过继电器。

### DSTUR-T80 USB继电器控制协议

```
端口：/dev/cu.usbmodem6670E00119391（Mac）
波特率：9600
指令格式：0xA0 [通道0x01~0x08] [0x01=ON / 0x00=OFF] [校验和]
校验和 = 通道 + 开关状态 + 0xA0（取低8位）
响应：文本，如 "CH1:ON"、"CH2:OFF"
```

> **注**：USB转RS485 适配器仍然需要，用于将来连接旋涂/移液模块，以及夹爪的 RS485 力/速度/位置调节（高级用途）。

---

## 参考资料位置

| 资料 | 文件路径 |
|---|---|
| 驱动器手册 | `hardware/datasheets/2HSS57-C (V2.01-T) (1).pdf` |
| 刹车继电器接线图 | `hardware/datasheets/photos/photo_2026-03-09_23-12-59.jpg` |
| 驱动器实物照（正面端子） | `hardware/datasheets/photos/photo_2026-03-09_23-25-35.jpg` |
| 传感器型号确认 | `hardware/datasheets/photos/photo_2026-03-09_23-25-41.jpg` |
| 电机铭牌（接线定义） | `hardware/datasheets/photos/photo_2026-03-09_23-25-47.jpg` |
| 感应片和安装座实物 | `hardware/datasheets/photos/photo_2026-03-10_20-38-10.jpg` |
| Arduino Mega 2560 实物 | `hardware/datasheets/photos/photo_2026-03-16_16-14-22.jpg` |
| 驱动器正面（标签+端子） | `hardware/datasheets/photos/photo_2026-03-16_16-14-28.jpg` |
| 驱动器侧面（拨码开关） | `hardware/datasheets/photos/photo_2026-03-16_16-14-32.jpg` |
| 24V电源 MAVN S-360-24 | `hardware/datasheets/photos/photo_2026-03-16_16-14-35.jpg` |
| 3D模型图纸 | `hardware/GH40-D75-X300S-Y300S-Z100S-57.STEP`（FreeCAD打开） |
| 机械组装教程 | `hardware/tutorials/01-机械组装教程.md` |
| 电控接线教程 | `hardware/tutorials/02-电控接线教程.md` |
