weng1259/autospin/hardware/龙门架/GH40-D75-X300S-Y300S-Z100S-57.STEP

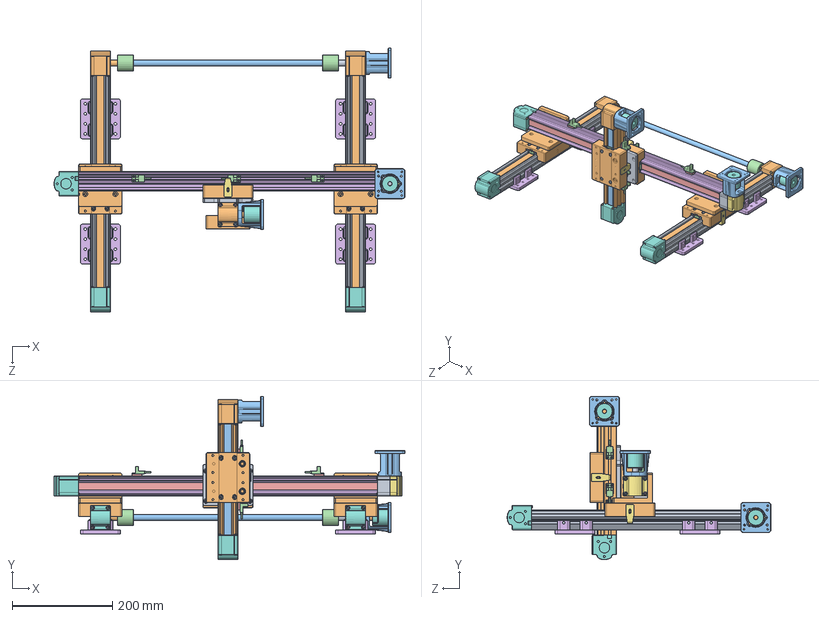
[picture p37: CAD file, 2026-06-17]
hardware/龙门架/GH40-D75-X300S-Y300S-Z100S-57.STEP
700.0 x 326.0 x 526.0 mm
40-倰第 x 2
40ﾎｲﾗ0+0 x 4
40ﾎｲﾗ25+25
40賑輸 x 4
40ﾎｲﾗ25+0 x 2
12嫖粣
薊粣んM12-12 x 2
40寢褽_X1
40ﾎｲﾗ0+25
40寢褽_Z1
40嫖萇 x 6
40菁釱 x 4
40-覜茼え x 3
薊粣んM12-8 x 3
T倰啣-40
4045L蟀諉啣 x 2
4045-57电机笼副本 x 3
