weng1259/autospin/migration_snapshot/2026-07-25/HARDWARE_ACCEPTANCE_RESULT.md

# Hardware Acceptance Result

## Run Information

| Field | Value |
| --- | --- |
| Date | |
| Platform | AutoSpinmotorSystem migrated to autospin |
| Raspberry Pi | |
| Git commit | |
| Configuration checksum | |
| Operator | |
| Observer | |
| Log directory | |

## 1. Communication

| Check | Result | Evidence / Notes |
| --- | --- | --- |
| [ ] RS485 | NOT RUN | |
| [ ] Relay | NOT RUN | |
| [ ] USB serial | NOT RUN | |

## 2. Motion

| Check | Result | Evidence / Notes |
| --- | --- | --- |
| [ ] Gantry homing (`$H`) | NOT RUN | |
| [ ] Absolute coordinated XYZ movement (`$J=G90`) | NOT RUN | |
| [ ] Gantry emergency stop (Ctrl-X) | NOT RUN | |

## 3. Liquid Handling

| Check | Result | Evidence / Notes |
| --- | --- | --- |
| [ ] Pipette communication and home | NOT RUN | |
| [ ] Tip pickup | NOT RUN | |
| [ ] Dispense | NOT RUN | |

## 4. Thermal

| Check | Result | Evidence / Notes |
| --- | --- | --- |
| [ ] Heater temperature control | NOT RUN | |

## 5. Integrated Workflow

| Check | Result | Evidence / Notes |
| --- | --- | --- |
| [ ] Pick | NOT RUN | |
| [ ] Dispense | NOT RUN | |
| [ ] Spin | NOT RUN | |
| [ ] Anneal | NOT RUN | |

## Failure Log

| Time | Module | Command / Step | Observed Failure | Error / Alarm | Safety Action |
| --- | --- | --- | --- | --- | --- |
| | | | | | |

## Recovery

| Failure Reference | Recovery Action | State Revalidated | Result | Notes |
| --- | --- | --- | --- | --- |
| | | | NOT RUN | |

## Final Status

Select one:

- [ ] PASS
- [ ] PASS WITH LIMITATIONS
- [ ] FAIL
- [ ] NOT RUN

### Limitations / Restrictions

### Final Notes

## Approval

| Role | Name | Signature / Confirmation | Date |
| --- | --- | --- | --- |
| Operator | | | |
| Observer | | | |
| Project owner | | | |
