weng1259/autospin/docs/verification/README.md

# Phase 3.1 验收日志

每个 Slice 完成后 PM 亲自在浏览器点按钮验收，结果归档在这里。

格式约定见 [feedback_vertical_slices_ui_validation](../../../../.claude/projects/-Users-kevin-Code------/memory/feedback_vertical_slices_ui_validation.md)。

> ⚠️ 本目录是**验收日志**，不是教程。详尽的 L3 API 教程会在 Phase 3.4 末统一写到 `docs/guides/06-l3-api-tutorial.md`，那时直接复用本目录的截图。

## Phase 3.1 进度

| Slice | 主题 | PM 签字 | 验收文档 |
|---|---|---|---|
| 前置 | src/ 骨架 + Streamlit 启动 | ✅ 2026-04-20 | （见 Slice 1 文档开头） |
| 1 | 查状态按钮 | ✅ 2026-04-20 | [slice-1-status-query.md](slice-1-status-query.md) |
| 2 | 归零按钮 + 历史记录 | ✅ 2026-04-20 | [slice-2-home-and-history.md](slice-2-home-and-history.md) |
| 3 | 去这里 + 实时位置 + 急停 | ✅ 2026-04-20 | [slice-3-move-to.md](slice-3-move-to.md) |
| 4 | 错误中文化 + 建议动作 | ✅ 2026-04-22 | [slice-4-error-i18n.md](slice-4-error-i18n.md) |
| 5 | alarm 一键恢复 + `$J=` backpatch | ✅ 2026-04-22 | [slice-5-recovery.md](slice-5-recovery.md) |
| 整体 | 端到端剧本 | ✅ 2026-04-22（脚本 `slice5_automated_acceptance.py` 场景 B 自动覆盖） | [slice-5-recovery.md §场景 B](slice-5-recovery.md) |

## Phase 3.3 现场记录

| 主题 | 日期 | 文档 |
|---|---|---|
| `$H` 报 `ALARM:9`，降回 `$24=25` / `$25=500` 后恢复 | 2026-04-24 | [phase-3.3-homing-alarm9-recovery.md](phase-3.3-homing-alarm9-recovery.md) |

## 验收文档模板（每个 Slice 一份）

固定 6 段：

1. **元信息** —— 日期 / 关联 plan / PM 签字
2. **一句话目标** —— 从 plan 摘抄
3. **验收清单** —— plan 里的 checkbox 表格 + ✅/❌ + 截图编号
4. **关键截图** —— 嵌入 + 一句话说明
5. **已发现+已处理的问题** —— bug、cosmetic、配置坑
6. **给后续 tutorial 的 hook** —— 哪些细节将在教程文档里展开
