weng1259/autospin/docs/devlog/2026-03-05.md

# 开发日志 — 2026-03-05

## 记录人

FENG

## 今日工作

- 收到 GH40 龙门架全部货物，开始机械组装
- 编写从零开始的保姆级组装教程（`龙门架组装教程.md`，最终扩展至 2600+ 行，覆盖 8 个组装阶段）
- 创建 `采购清单.md` 和 `README.md`，建立项目基本文档框架
- 对照报价单和实物逐一清点零件

## 遇到的问题

1. Y轴有一根双出轴、一根单出轴，不清楚区别
2. 联轴器两端插入深度不确定
3. X轴模组两端被L型板堵住，T型螺母无法从端头塞入
4. 传感器和感应片外观不认识，教程描述模糊
5. 螺丝型号不确定（M4还是M5）
6. 36V 10A电源难找

## 解决方案

1. 双出轴装电机侧（一端接电机、一端接连接杆），单出轴装从动侧（只接连接杆）
2. 联轴器两端各插到长度一半，中间留间隙，不能顶死
3. T型螺母可以竖着从T型槽侧面旋转塞入
4. 根据实物照片重写零件描述，加入辨识要点
5. 建议用 FreeCAD 打开 STEP 量孔径，或直接问商家确认
6. 驱动器支持 24~48V，改为买 24V 15A 电源（更常见、更便宜，还能合并刹车供电）

## 下次计划

- 继续机械组装：固定电机、安装联轴器
- 安装传感器和感应片
- 等 Arduino 和其他采购物品到货

## 备注（照片/截图/参考链接）

- 龙门架型号：GH40-D75-X300S-Y300S-Z100S-57（港豪），总价 3184 元
- 3D模型文件：`hardware/GH40-D75-X300S-Y300S-Z100S-57.STEP`
