weng1259/autospin/docs/devlog/2026-03-09.md

# 开发日志 — 2026-03-09

## 记录人

FENG

## 今日工作

- 继续安装 DS-ES61 槽型光电传感器（需拆底座，因 X 轴遮挡安装位置）
- Arduino Mega 2560 到货
- 续写电控接线教程（从第九阶段开始，新增约 1600 行）
- 根据实物照片修正多处教程错误：
  - 电源端子顺序：实物为 `+V +V -V -V ⏚ N L`（24V在左，220V在右）
  - 驱动器端子名称：电源接 `(+)/(-)` 而非 `VCC/GND`
  - 拨码开关方向：ON 印在下方，向下拨 = ON
  - 编码器接口：实际是 DB9 插头，非散线
- 确认开环模式（SW8=ON）不接编码器即可运行

## 遇到的问题

1. 教程中"传感器装到什么位置"描述不清
2. 编码器出来是 DB9 插头，驱动器是螺丝端子，无法直接连接
3. 拨码开关 ON/OFF 方向和教程写的相反
4. 电源端子顺序和预期相反

## 解决方案

1. 根据实物照片重写传感器安装步骤，加入具体位置图示
2. 采购清单新增 DB9 免焊接头母头 ×3（约 12 元），用于转接
3. 根据照片修正拨码方向描述
4. 根据照片修正电源端子顺序

## 下次计划

- 淘宝下单：万用表、继电器、DB9免焊接头等（约 81 元）
- 装完全部 9 个传感器
- 按教程顺序：电源接线 → Arduino 信号线 → 通电测试

## 备注（照片/截图/参考链接）

- 驱动器手册确认：SW8=ON 开环模式，无需编码器
- 传感器支持 5V，可直接接 Arduino，不需要光耦隔离
