weng1259/autospin/docs/devlog/2026-03-17a.md

# 开发日志 — 2026-03-17（采购清单定稿）

## 记录人

FENG

## 今日工作

- 确认电源接线方案：三芯电源线（3×1.0mm²，国标三脚插头，散线端）
- 更新完整采购清单并生成 Word 版（`采购清单.docx`）
- 确认继电器型号：正泰 NXJ/2Z 24VDC，8脚（/2Z = 2组转换触点）
- 精简采购清单：确认不需要降压模块（Arduino 用 USB 供电）、不需要额外电子线

## 遇到的问题

1. 电源没有自带线，需要单独购买
2. 继电器脚位数不确定（8脚还是11脚）
3. 之前讨论过的 LM2596 降压模块是否需要

## 解决方案

1. 购买三芯电源线（1.5米，约8元），散线端接电源 L/N/⏚
2. 确认 NXJ/2Z 就是8脚，2组触点刚好满足刹车控制需求
3. 不需要降压模块：Arduino 用 USB 供电，传感器接 Arduino 5V 引脚

## 下次计划

- 等全部采购到货后开始接线

## 备注（照片/截图/参考链接）

- 采购总计约 81 元，10 项
- Word 版已生成，可直接打印或发给组员参考
