weng1259/autospin/docs/devlog/2026-03-17c.md

# 开发日志 — 2026-03-17 ~ 2026-03-19（三轴电机控制开发）

## 记录人

FENG

## 今日工作

- 完成 220V 电源输入线接线
- 完成三轴 Arduino 信号线接线（共阳极接法，5V跳接方式）
- 编写单轴测试固件（Y轴），Y轴电机首次通电成功运转
- 扩展为三轴固件（D2/D3=X轴，D4/D5=Y轴，D6/D7=Z轴）
- 开发网页控制面板（`web_control/index.html`），支持点动/长按/速度调节/键盘快捷键
- 修正 X 轴和 Z 轴方向取反问题
- **里程碑：三轴电机全部通电运转成功，网页控制可用**

## 遇到的问题

1. Arduino 只有2个5V引脚，但需给3个驱动器共6个端子（PLS+/DIR+）供5V
2. 3根杜邦线无法同时插进 Arduino 同一5V引脚
3. 信号线误接模拟引脚（A2/A3），应接数字引脚 D2-D7
4. 不熟悉 Arduino Mega 引脚排布（D22-D53大排 vs D0-D13小排）
5. 上传固件时串口被Web Serial API后台占用，关闭网页仍无法释放，需重启电脑
6. X轴和Z轴方向与网页控制面板中的预期方向相反

## 解决方案

1. 驱动器端子之间用短线跳接，串联传递5V，每个Arduino引脚只插1根线
2. 同上，跳接方案解决
3. D2-D7 位于 USB 口旁的小排针（DIGITAL），非大排针区域
4. 根据实物照片标注引脚位置
5. **关键经验**：上传固件前必须先关闭网页控制面板，否则需重启电脑恢复串口
6. 在固件中对调 X/Z 轴的 HIGH/LOW 方向逻辑

## 下次计划

- 接传感器到 Arduino（D22-D30）
- 等 DB9 免焊接头到货后接编码器，切换闭环模式
- 等继电器到货后完成 Z 轴刹车接线
- 添加限位保护逻辑

## 备注（照片/截图/参考链接）

- 网页控制地址：`localhost:8080`（需先启动 `python3 -m http.server 8080`）
- 键盘快捷键：A/D=X轴、←/→=Y轴、W/S=Z轴、空格=全部停止
- 固件位置：`firmware/motor_control/motor_control.ino`
