weng1259/autospin/docs/devlog/2026-03-19a.md

# 开发日志 — 2026-03-19（下一步规划）

## 记录人

FENG

## 今日工作

- 三轴电机网页控制已稳定运行，进行下一步规划讨论
- 整理剩余硬件任务优先级
- 确认 DB9 免焊接头、继电器、万用表已下单

## 遇到的问题

- 无新问题，主要是规划讨论

## 解决方案

（无）

## 下次计划

1. 接传感器到 Arduino（D22-D30）— 不需要额外采购，现在就能做
2. 买 DB9 免焊接头（母头）×3 → 接编码器 → SW8 拨回 OFF 切闭环
3. 买继电器 NXJ/2Z 24VDC → 接 Z 轴刹车
4. 编写正式运动控制固件（加减速、限位保护、归零流程）
5. 部署树莓派作为上位机

## 备注（照片/截图/参考链接）

- Y轴电机线太短的问题后续需要解决（加拖链或延长线）
