weng1259/autospin/docs/devlog/2026-03-19b.md

# 开发日志 — 2026-03-19（RS485架构决策）

## 记录人

FENG

## 今日工作

- 讨论并确定旋涂模块和移液模块的 RS485 控制架构
- 确认 RS485 设备由上位机直连，不经过 Arduino
- 更新 `docs/architecture.md`：重写当前架构和目标架构图
- 同步更新 `README.md` 和 `hardware/tutorials/02-电控接线教程.md`

## 遇到的问题

- 原架构文档中 RS485 走 Arduino Serial1 + MAX485，方案不够好

## 解决方案

- 改为上位机（Mac/树莓派）通过 USB转RS485 适配器直连旋涂/移液模块
- 理由：职责分离、互不干扰、调试方便、Python pymodbus 库更成熟、Arduino 固件保持简单

## 下次计划

- 购买 USB转RS485 适配器（CH340芯片，约15元）
- 旋涂模块和移液模块的 RS485 协议调试

## 备注（照片/截图/参考链接）

- 目标架构确认：上位机（Mac/树莓派）→ USB串口 → Arduino（电机+传感器）/ USB转RS485 → 旋涂+移液模块
