weng1259/autospin/docs/devlog/2026-03-23.md

# 开发日志 — 2026-03-23

## 记录人

FENG

## 今日工作

- 9路光电传感器（DS-ES61）全部接线到 Arduino D22-D30
- 更新固件 `motor_control.ino`：新增传感器引脚初始化和 150ms 周期状态上报（`SENS:XXXXXXXXX`）
- 新建网页传感器测试工具 `web_control/sensor_test.html`：
  - 集成三轴电机控制 + 9路传感器实时可视化
  - 传感器触发时亮绿色，记录"已验证"状态，9/9 通过显示成功
  - 支持键盘快捷键、速度调节、重置测试
- 传感器测试全部通过（9/9）

## 遇到的问题

- 传感器逻辑反了：DS-ES61 是 NPN 亮通型，槽内无遮挡时 NPN 导通拉 LOW，有遮挡时变 HIGH
- 初始代码用 `LOW == 触发`，导致一上来就显示全部触发

## 解决方案

- 将固件中判断逻辑改为 `HIGH == 触发`（`digitalRead() == HIGH ? '1' : '0'`）

## 下次计划

- Z轴刹车继电器接线（继电器已到货）
- DB9 编码器接线 → 切换闭环模式
- 归零和限位测试

## 备注（照片/截图/参考链接）

- 传感器测试工具：`web_control/sensor_test.html`
- DS-ES61 传感器特性：NPN 亮通型，INPUT_PULLUP 配合使用，HIGH = 有遮挡（触发）
