weng1259/autospin/docs/devlog/2026-03-24.md

# 2026-03-24 开发日志

## 闭环模式启用

- DB9 编码器免焊接头接线完成（3 个电机都接好）
- 驱动器 SW8 从 ON（开环）改为 OFF（闭环）
- 初始细分设置：SW3=OFF SW4=OFF SW5=ON SW6=ON → 3200（后经实测发现不准，已改为 51200，见下方"步距实测"）

## 固件升级 v2

文件：`firmware/motor_control/motor_control.ino`

新增功能：
1. **位置追踪**：每个脉冲计数，每 150ms 上报 `POS:x,y,z`（有符号步数）
2. **ALM 报警监控**：D31/D32/D33 读取驱动器报警信号，上报 `ALM:xyz`
3. **梯形加减速**：连续运动从 `目标速度+600μs` 起步，每批 200μs 递减到目标
4. **新命令**：`P` 查询位置、`HR` 归零复位

串口输出变为每 150ms 三行：
```
SENS:000000000
POS:12345,-678,0
ALM:000
```

向后兼容：sensor_test.html 和 homing_test.html 只认 SENS 行，不受影响。

## 网页控制面板重写

文件：`web_control/index.html`

- 从暗色主题完全重写为 Apple 简约风格（浅色背景、白色卡片）
- 布局从 400px 窄屏改为全宽双栏（桌面端左画布右控制，手机端单栏）
- 新增 XY 位置画布（Canvas，300×300mm 网格，蓝色位置点 + 虚线十字）
- 新增 Z 轴高度竖条
- 新增位置读数（mm + 步数）
- 新增 9 路传感器状态指示灯
- 新增 3 轴驱动器报警监控（报警时红色高亮）
- 日志窗口改为可折叠（默认收起）
- 触摸事件改用 addEventListener + passive:false（修复旧版无效的 ontouchstart.prevent）
- 串口读取改为缓冲逐行解析（参考 homing_test.html 的实现）

## Bug 修复

- Z 轴 ↑↓ 按钮方向修正（↑=后退=物理上升，匹配旧代码）
- W/S 键盘映射同步修正
- 加速参数调整：起步延迟从固定 2000μs 改为 `stepDelay+600μs`，递减步长从 20 改为 200

## 步距实测

产品画册确认传动方式：**HTD3M 同步带 × 25 齿** → 每转行程 = 3mm × 25 = **75mm/转**

拨码 SW3-SW6 标称 3200 细分，但闭环模式下实测：

| 脉冲数 | 观察结果 |
|---|---|
| 200 | 约 3/4 圈 |
| 300 | 差一点到一圈 |
| 350 | 刚过一圈 |
| 400 | 多了约 1/4 圈 |

→ 实测 **~320 脉冲/转**（闭环下有效细分 = 标称 ÷ 10）

```
320 脉冲/转 ÷ 75mm/转 ≈ 4.27 步/mm
最小步距 ≈ 0.234mm
```

之前文档中所有步距值（80、640、1280、42.67 步/mm）均错误，待调参确定最终细分后统一更新。

### 细分调整验证

将 SW5 从 ON 改为 OFF → SW3=OFF SW4=OFF SW5=OFF SW6=ON（标称 51200 细分）

实测：5000 脉冲 ≈ 1 圈 → 闭环实测 **~5120 脉冲/转**，确认"÷10"规律成立。

**最终采用参数**：
```
拨码：SW3=OFF SW4=OFF SW5=OFF SW6=ON（51200）
闭环实测：~5120 脉冲/转 ← ⚠️ 此实测值可能有误，见下方注释
传动：HTD3M × 25齿 = 75mm/转
steps/mm = 5120 ÷ 75 ≈ 68.3 ← ⚠️ 已修正为 51200 ÷ 75 = 682.67
最小步距 ≈ 0.015mm
```

> **2026-03-25 修正**：上述"闭环实测 ~5120 脉冲/转"存疑。按驱动器手册 p15 细分表，
> SW3-6=OFF/OFF/OFF/ON 对应 51200 脉冲/转，不存在"÷10"规律。
> 正确计算：51200 ÷ 75 = **682.67 步/mm**。详见 `docs/hardware-specs.md`。
> **2026-03-26 已实测确认**：MOVE 6827 步 ≈ 10mm，682.67 步/mm 正确。

## 待办

- [ ] 按 `docs/guides/05-固件测试.md` 完成 Phase 2a 串口联调
- [ ] 网页调试面板迁移到新行文本协议（当前旧版 `web_control/` 不兼容 2a 固件）
- [ ] ALM 报警物理接线（D31/D32/D33 ← 驱动器 ALM+，需 3.3K 上拉电阻）
- [ ] 归零和限位实测
- [ ] 确认刹车控制行为是否正常
- [ ] 调整驱动器细分设置，确定最终 steps/mm 后更新所有文档

## Phase 2a 固件重构

文件：`firmware/motor_control/motor_control.ino`

- 将旧两字符测试协议替换为新行文本协议（命令以 `\n` 结尾）
- 新增状态机骨架：`IDLE` / `MOVING` / `ERROR` / `ESTOP`
- `IDLE` 状态允许 `JOG`，但未回零时坐标只表示相对步数
- 串口解析改为非阻塞 `cmdBuffer` 逐字符读取，不再使用 `while (!Serial.available())` 忙等
- 实现命令：`JOG` / `STOP` / `ESTOP` / `RESET` / `POS` / `SENS` / `STATE` / `SPEED`
- 加入固件层限位保护：每批脉冲前检查当前方向对应的正/负限位，触发后上报 `@LIMIT`、`@FAULT` 并进入 `ERROR`
- `HOME` / `MOVE` 暂未实现，当前返回 `ERR:TODO`，留待 2b

### 编译与上传

- 编译命令：

```bash
arduino-cli compile --fqbn arduino:avr:mega --build-path /tmp/arduino-motor-control-build firmware/motor_control
```

- 编译结果：
  - Flash：8688 bytes（3%）
  - RAM：611 bytes（7%）

- 上传端口：`/dev/cu.wchusbserial110`
- 上传结果：成功

### 同步文档

- 新增 `docs/guides/05-固件测试.md`，作为 2a 串口联调测试清单
- `docs/guides/04-固件开发.md` 的 2a 验证记录已更新为“代码完成，待实机验证”
- `README.md` 已更新当前阶段说明和测试文档入口

### 当前限制

- 现有 `web_control/index.html`、`sensor_test.html`、`homing_test.html` 仍基于旧两字符协议，当前不能直接驱动这版固件
- 本轮先用串口工具按 `05-固件测试.md` 联调，网页协议迁移放到下一步
