weng1259/autospin/docs/devlog/2026-03-19c.md

# 开发日志 — 2026-03-19（文档架构重组）

## 记录人

FENG

## 今日工作

- 设计并实施项目文档规范化架构
- 重组目录结构：
  - `采购清单.md/.docx` 移至 `hardware/`
  - 设备PDF移至 `hardware/datasheets/`，照片移至 `hardware/datasheets/photos/`
  - 创建 `tools/` 目录存放辅助脚本
  - 创建 `docs/devlog/`（开发日志）、`docs/decisions/`（决策记录）
- 将 2650 行的龙门架组装教程拆分为两个独立文件：
  - `hardware/tutorials/01-机械组装教程.md`（883行）
  - `hardware/tutorials/02-电控接线教程.md`（1769行）
- 创建开发日志模板（`docs/devlog/_template.md`）
- 创建踩坑汇总骨架（`docs/troubleshooting.md`）

## 遇到的问题

- 现有文档和硬件实际状态有一定出入，需要后续对齐检查

## 解决方案

（后续逐步校对）

## 下次计划

- 检查文档与当前硬件实际状态的一致性
- 从聊天记录中提取内容填充开发日志、决策记录、踩坑汇总

## 备注（照片/截图/参考链接）

- 项目计划商业化，需准备操作手册、说明书，因此必须提前规范文档架构
- 团队规模：导师 + 2人
