weng1259/autospin/firmware/grbl_spike/our_config/grbl_settings.txt

$0=10
$1=255
$2=0
$3=6
$4=0
$5=1
$6=0
$10=2
$11=0.020
$12=0.002
$13=0
$20=1
$21=1
$22=1
$23=0
$24=25
$25=500
$26=250
$27=5
$30=12000
$31=550
$32=0
$100=682.670
$101=682.670
$102=682.670
$110=3000
$111=3000
$112=3000
$120=200
$121=200
$122=200
$130=280
$131=280
$132=95
