weng1259/autospin/firmware/grbl_spike/our_config/cpu_map.h

/*
  cpu_map.h - CPU and pin mapping configuration file
  Part of Grbl

  Copyright (c) 2017-2022 Gauthier Briere
  Copyright (c) 2012-2016 Sungeun K. Jeon for Gnea Research LLC

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
  You should have received a copy of the GNU General Public License
  along with Grbl.  If not, see <http://www.gnu.org/licenses/>.
*/

/* The cpu_map.h files serve as a central pin mapping selection file for different
   processor types or alternative pin layouts. This version of Grbl supports only the
   Arduino Mega2560. */

#ifndef cpu_map_h
#define cpu_map_h

#ifdef CPU_MAP_2560_RAMPS_BOARD // (Arduino Mega 2560) with Ramps 1.4 Board
  #include "nuts_bolts.h"

  // Serial port interrupt vectors
  #define SERIAL_RX USART0_RX_vect
  #define SERIAL_UDRE USART0_UDRE_vect

  // Define ports and pins
  #define DDR(port) DDR##port
  #define _DDR(port) DDR(port)
  #define PORT(port) PORT##port
  #define _PORT(port) PORT(port)
  #define PIN(pin) PIN##pin
  #define _PIN(pin) PIN(pin)

  // Define step pulse output pins.
  // 智能旋涂仪 remap: X=D2(PE4), Y=D4(PG5), Z=D6(PH3)

  #define STEP_PORT_0 E
  #define STEP_PORT_1 G
  #define STEP_PORT_2 H
  #if N_AXIS > 3
    #define STEP_PORT_3 A // Axis number 4 (Ramps E0)
  #endif
  #if N_AXIS > 4
    #define STEP_PORT_4 C // Axis number 5 (Ramps E1)
  #endif
  #if N_AXIS > 5
    #define STEP_PORT_5 L // Axis number 6 (Ramps Aux-3 D49)
  #endif
  #define STEP_BIT_0 4  // X Step - D2 (PE4)
  #define STEP_BIT_1 5  // Y Step - D4 (PG5)
  #define STEP_BIT_2 3  // Z Step - D6 (PH3)
  #if N_AXIS > 3
    #define STEP_BIT_3 4 // Axis number 4 Step - Pin D26
  #endif
  #if N_AXIS > 4
    #define STEP_BIT_4 1 // Axis number 5 Step - Pin D36
  #endif
  #if N_AXIS > 5
    #define STEP_BIT_5 0 // Axis number 6 Step - Pin D49
  #endif
  #define _STEP_BIT(i) STEP_BIT_##i
  #define STEP_BIT(i) _STEP_BIT(i)
  #define STEP_DDR(i) _DDR(STEP_PORT_##i)
  #define _STEP_PORT(i) _PORT(STEP_PORT_##i)
  #define STEP_PORT(i) _STEP_PORT(i)
  #define STEP_PIN(i) _PIN(STEP_PORT_##i)

  // Define step direction output pins.
  // 智能旋涂仪 remap: X=D3(PE5), Y=D5(PE3), Z=D7(PH4)
  #define DIRECTION_PORT_0 E
  #define DIRECTION_PORT_1 E
  #define DIRECTION_PORT_2 H
  #if N_AXIS > 3
    #define DIRECTION_PORT_3 A // Axis number 4 (Ramps E0)
  #endif
  #if N_AXIS > 4
    #define DIRECTION_PORT_4 C // Axis number 5 (Ramps E1)
  #endif
  #if N_AXIS > 5
    #define DIRECTION_PORT_5 B // Axis number 6 (Ramps Aux-3 D51)
  #endif
  #define DIRECTION_BIT_0 5 // X Dir - D3 (PE5)
  #define DIRECTION_BIT_1 3 // Y Dir - D5 (PE3)
  #define DIRECTION_BIT_2 4 // Z Dir - D7 (PH4)
  #if N_AXIS > 3
    #define DIRECTION_BIT_3 6 // Axis number 4 Step - Pin D28
  #endif
  #if N_AXIS > 4
    #define DIRECTION_BIT_4 3 // Axis number 5 Step - Pin D34
  #endif
  #if N_AXIS > 5
    #define DIRECTION_BIT_5 2 // Axis number 6 Step - Pin D51
  #endif
  #define _DIRECTION_BIT(i) DIRECTION_BIT_##i
  #define DIRECTION_BIT(i) _DIRECTION_BIT(i)
  #define DIRECTION_DDR(i) _DDR(DIRECTION_PORT_##i)
  #define _DIRECTION_PORT(i) _PORT(DIRECTION_PORT_##i)
  #define DIRECTION_PORT(i) _DIRECTION_PORT(i)
  #define DIRECTION_PIN(i) _PIN(DIRECTION_PORT_##i)

  // Define stepper driver enable/disable output pin.
  #define STEPPER_DISABLE_PORT_0 D
  #define STEPPER_DISABLE_PORT_1 F
  #define STEPPER_DISABLE_PORT_2 K
  #if N_AXIS > 3
    #define STEPPER_DISABLE_PORT_3 A // Axis number 4 (Ramps E0)
  #endif
  #if N_AXIS > 4
    #define STEPPER_DISABLE_PORT_4 C // Axis number 5 (Ramps E1)
  #endif
  #if N_AXIS > 5
    #define STEPPER_DISABLE_PORT_5 B // Axis number 5 (Ramps Aux-3 D53)
  #endif
  #define STEPPER_DISABLE_BIT_0 7 // X Enable - Pin D38
  #define STEPPER_DISABLE_BIT_1 2 // Y Enable - Pin A2
  #define STEPPER_DISABLE_BIT_2 0 // Z Enable - Pin A8
  #if N_AXIS > 3
    #define STEPPER_DISABLE_BIT_3 2 // Axis number 4 Step - Pin D24
  #endif
  #if N_AXIS > 4
    #define STEPPER_DISABLE_BIT_4 7 // Axis number 5 Step - Pin D30
  #endif
  #if N_AXIS > 5
    #define STEPPER_DISABLE_BIT_5 0 // Axis number 5 Step - Pin D53
  #endif
  #define STEPPER_DISABLE_BIT(i) STEPPER_DISABLE_BIT_##i
  #define STEPPER_DISABLE_DDR(i) _DDR(STEPPER_DISABLE_PORT_##i)
  #define STEPPER_DISABLE_PORT(i) _PORT(STEPPER_DISABLE_PORT_##i)
  #define STEPPER_DISABLE_PIN(i) _PIN(STEPPER_DISABLE_PORT_##i)

  // Define homing/hard limit switch input pins and limit interrupt vectors.
  // 智能旋涂仪 remap: 限位都在 PORTA/PORTC（无 PCINT），用 ENABLE_RAMPS_HW_LIMITS 轮询
  // X-=D22(PA0)  Y-=D25(PA3)  Z-=D28(PA6)
  #define MIN_LIMIT_PORT_0 A
  #define MIN_LIMIT_PORT_1 A
  #define MIN_LIMIT_PORT_2 A
  #if N_AXIS > 3
    #define MIN_LIMIT_PORT_3 L
  #endif
  #if N_AXIS > 4
    #define MIN_LIMIT_PORT_4 L
  #endif
  #if N_AXIS > 5
    #define MIN_LIMIT_PORT_5 F // (Ramps Aux-1 D57)
  #endif
  #define MIN_LIMIT_BIT_0 0 // X Limit Min - D22 (PA0)
  #define MIN_LIMIT_BIT_1 3 // Y Limit Min - D25 (PA3)
  #define MIN_LIMIT_BIT_2 6 // Z Limit Min - D28 (PA6)
  #if N_AXIS > 3
    #define MIN_LIMIT_BIT_3 7 // Axis number 4 : RAMPS AUX2 pin D42
  #endif
  #if N_AXIS > 4
    #define MIN_LIMIT_BIT_4 5 // Axis number 5 : RAMPS AUX2 pin D44
  #endif
  #if N_AXIS > 5
    #define MIN_LIMIT_BIT_5 3 // Axis number 6 : RAMPS AUX2 pin D57
  #endif
  #define _MIN_LIMIT_BIT(i) MIN_LIMIT_BIT_##i
  #define MIN_LIMIT_BIT(i) _MIN_LIMIT_BIT(i)
  #define MIN_LIMIT_DDR(i) _DDR(MIN_LIMIT_PORT_##i)
  #define MIN_LIMIT_PORT(i) _PORT(MIN_LIMIT_PORT_##i)
  #define MIN_LIMIT_PIN(i) _PIN(MIN_LIMIT_PORT_##i)

  // X+=D24(PA2)  Y+=D27(PA5)  Z+=D30(PC7)  ← 用作 homing 触发
  #define MAX_LIMIT_PORT_0 A
  #define MAX_LIMIT_PORT_1 A
  #define MAX_LIMIT_PORT_2 C
  #if N_AXIS > 3
    #define MAX_LIMIT_PORT_3 G
  #endif
  #if N_AXIS > 4
    #define MAX_LIMIT_PORT_4 F
  #endif
  #if N_AXIS > 5
    #define MAX_LIMIT_PORT_5 F // (Ramps Aux-3 D58)
  #endif
  #define MAX_LIMIT_BIT_0 2 // X Limit Max - D24 (PA2)
  #define MAX_LIMIT_BIT_1 5 // Y Limit Max - D27 (PA5)
  #define MAX_LIMIT_BIT_2 7 // Z Limit Max - D30 (PC7)
  #if N_AXIS > 3
    #define MAX_LIMIT_BIT_3 1 // Axis number 4 : RAMPS AUX2 pin D40
  #endif
  #if N_AXIS > 4
    #define MAX_LIMIT_BIT_4 5 // Axis number 5 : RAMPS AUX2 pin D59
  #endif
  #if N_AXIS > 5
    #define MAX_LIMIT_BIT_5 4 // Axis number 6 : RAMPS AUX2 pin D58
  #endif
  #define _MAX_LIMIT_BIT(i) MAX_LIMIT_BIT_##i
  #define MAX_LIMIT_BIT(i) _MAX_LIMIT_BIT(i)
  #define MAX_LIMIT_DDR(i) _DDR(MAX_LIMIT_PORT_##i)
  #define MAX_LIMIT_PORT(i) _PORT(MAX_LIMIT_PORT_##i)
  #define MAX_LIMIT_PIN(i) _PIN(MAX_LIMIT_PORT_##i)

  // Enable Hardware limit support for RAMPS without using interrupt...
  // Warning! bouncing switches can cause a state check like this to misread the pin.
  // When hard limits are triggered, they should be 100% reliable.
  // The RAMPS_HW_LIMIT is implemented inside the stepper driver interrupt. Depending of your
  // hardware, this can affect the max speed possibility of movments
  // Disabled by default for performance optimization, uncomment to enable.
  #define ENABLE_RAMPS_HW_LIMITS  // 智能旋涂仪: 限位在 PORTA/C（无 PCINT），必须开

  // Define spindle enable and spindle direction output pins.
  // 智能旋涂仪 remap: 默认的 D4/D5 与我们的 Y STEP/DIR 撞车，搬到 D40(PG1)/D41(PG0)
  // 我们没有 spindle 硬件，这两个 pin 实际没接东西，只是占位
  #define SPINDLE_ENABLE_DDR      DDRG
  #define SPINDLE_ENABLE_PORT     PORTG
  #define SPINDLE_ENABLE_BIT      1 // D40 (PG1)
  #define SPINDLE_DIRECTION_DDR   DDRG
  #define SPINDLE_DIRECTION_PORT  PORTG
  #define SPINDLE_DIRECTION_BIT   0 // D41 (PG0)

  // Define flood and mist coolant enable output pins.
  #define COOLANT_FLOOD_DDR   DDRB
  #define COOLANT_FLOOD_PORT  PORTB
  #define COOLANT_FLOOD_BIT   4 // MEGA2560 Digital Pin 10 - Ramps 1.4 12v output
  #define COOLANT_MIST_DDR    DDRH
  #define COOLANT_MIST_PORT   PORTH
  #define COOLANT_MIST_BIT    6 // MEGA2560 Digital Pin 9 - Ramps 1.4 12v output

  // Define M62 - M65 Digital Output Control ports
  // D16 D17 D23 D25
  #define DIGITAL_OUTPUT_DDR_0  DDRH
  #define DIGITAL_OUTPUT_PORT_0 PORTH
  #define DIGITAL_OUTPUT_BIT_0  1 // MEGA2560 Digital Pin 16 - Ramps 1.4 AUX-4 D16
  #define DIGITAL_OUTPUT_DDR_1  DDRH
  #define DIGITAL_OUTPUT_PORT_1 PORTH
  #define DIGITAL_OUTPUT_BIT_1  0 // MEGA2560 Digital Pin 17 - Ramps 1.4 AUX-4 D17
  #define DIGITAL_OUTPUT_DDR_2  DDRA
  #define DIGITAL_OUTPUT_PORT_2 PORTA
  #define DIGITAL_OUTPUT_BIT_2  1 // MEGA2560 Digital Pin 23 - Ramps 1.4 AUX-4 D23
  #define DIGITAL_OUTPUT_DDR_3  DDRA
  #define DIGITAL_OUTPUT_PORT_3 PORTA
  #define DIGITAL_OUTPUT_BIT_3  3 // MEGA2560 Digital Pin 23 - Ramps 1.4 AUX-4 D25
  
  // Define user-control CONTROLs (cycle start, reset, feed hold) input pins.
  // NOTE: All CONTROLs pins must be on the same port and not on a port with other input pins (limits).
  #define CONTROL_DDR       DDRK
  #define CONTROL_PIN       PINK
  #define CONTROL_PORT      PORTK
  #define CONTROL_RESET_BIT         1  // Pin A9 - RAMPS Aux 2 Port
  #define CONTROL_FEED_HOLD_BIT     2  // Pin A10 - RAMPS Aux 2 Port
  #define CONTROL_CYCLE_START_BIT   3  // Pin A11 - RAMPS Aux 2 Port
  #define CONTROL_SAFETY_DOOR_BIT   4  // Pin A12 - RAMPS Aux 2 Port
  #define CONTROL_INT       PCIE2  // Pin change interrupt enable pin
  #define CONTROL_INT_vect  PCINT2_vect
  #define CONTROL_PCMSK     PCMSK2 // Pin change interrupt register
  #define CONTROL_MASK      ((1<<CONTROL_RESET_BIT)|(1<<CONTROL_FEED_HOLD_BIT)|(1<<CONTROL_CYCLE_START_BIT)|(1<<CONTROL_SAFETY_DOOR_BIT))

  // Define probe switch input pin.
  #define PROBE_DDR       DDRK
  #define PROBE_PIN       PINK
  #define PROBE_PORT      PORTK
  #define PROBE_BIT       7  // MEGA2560 Analog Pin 15
  #define PROBE_MASK      (1<<PROBE_BIT)

  #ifdef USE_ANALOG_INPUT
    // Define Analog input
    #define ANALOG_INPUT_DDR_0   DDRK
    #define ANALOG_INPUT_PIN_0   PINK
    #define ANALOG_INPUT_PORT_0  PORTK
    #define ANALOG_INPUT_BIT_0   6 // MEGA2560 Analog Pin 14
    #define ANALOG_INPUT_MASK_0  (1<<ANALOG_INPUT_BIT_0)
    #define ANALOG_INPUT_DDR_1   DDRK
    #define ANALOG_INPUT_PIN_1   PINK
    #define ANALOG_INPUT_PORT_1  PORTK
    #define ANALOG_INPUT_BIT_1   5 // MEGA2560 Analog Pin 13
    #define ANALOG_INPUT_MASK_1  (1<<ANALOG_INPUT_BIT_1)
  #endif

  #ifdef USE_DIGITAL_INPUT
    // Define digital input
    #define DIGITAL_INPUT_DDR_0   DDRA
    #define DIGITAL_INPUT_PIN_0   PINA
    #define DIGITAL_INPUT_PORT_0  PORTA
    #define DIGITAL_INPUT_BIT_0   5 // MEGA2560 Port D27
    #define DIGITAL_INPUT_MASK_0  (1<<DIGITAL_INPUT_BIT_0)
    #define DIGITAL_INPUT_DDR_1   DDRA
    #define DIGITAL_INPUT_PIN_1   PINA
    #define DIGITAL_INPUT_PORT_1  PORTA
    #define DIGITAL_INPUT_BIT_1   7 // MEGA2560 Port D29
    #define DIGITAL_INPUT_MASK_1  (1<<DIGITAL_INPUT_BIT_1)
    #define DIGITAL_INPUT_DDR_2   DDRC
    #define DIGITAL_INPUT_PIN_2   PINC
    #define DIGITAL_INPUT_PORT_2  PORTC
    #define DIGITAL_INPUT_BIT_2   6 // MEGA2560 Port D31
    #define DIGITAL_INPUT_MASK_2  (1<<DIGITAL_INPUT_BIT_2)
    #define DIGITAL_INPUT_DDR_3   DDRC
    #define DIGITAL_INPUT_PIN_3   PINC
    #define DIGITAL_INPUT_PORT_3  PORTC
    #define DIGITAL_INPUT_BIT_3   4 // MEGA2560 Port D33
    #define DIGITAL_INPUT_MASK_3  (1<<DIGITAL_INPUT_BIT_3)
  #endif

  //-------------------------------------------------------------------------------------------------------
  // Advanced Configuration Below You should not need to touch these variables
  //-------------------------------------------------------------------------------------------------------

  // Spindle PWM configuration :
  // list of timers in Arduino Mega 2560
  // TIMER0 (controls pin D13,  D4);      => Timer0 is used by stepper.c
  // TIMER1 (controls pin D12, D11);      => Timer1 is used by stepper.c
  // TIMER2 (controls pin D10,  D9);      => Timer2 is used by analog output or spindle PWM on D9
  // TIMER3 (controls pin  D5,  D3,  D2); => Timer3 is used by sleep.c
  // TIMER4 (controls pin  D8,  D7,  D6); => Timer4 is used by analog output or spindle PWM on D8 or D6
  // TIMER5 (controls pin D46, D45, D44); => Timer5 is unused by grbl-Mega-5X. It's possible to add 
  //                                         PWM capability to ports D44 (RAMPS AUX-2), D45 (RAMPS AUX-4). 
  //                                         D46 is not available for PWM because it's used by Z step.
  // Arduino pin number and the corresponding register for controlling the duty cycle :
  // Pin  Register
  //   2  OCR3B
  //   3  OCR3C
  //   4  OCR4C
  //   5  OCR3A
  //   6  OCR4A
  //   7  OCR4B
  //   8  OCR4C
  //   9  OCR2B
  //  10  OCR2A
  //  11  OCR1A
  //  12  OCR1B
  //  13  OCR0A
  //  44  OCR5C
  //  45  OCR5B
  //  46  OCR5A

  #if defined(SPINDLE_PWM_ON_D8)

    // Set Timer up to use TIMER4B which is attached to Digital Pin 8 - Ramps 1.4 12v output with heat sink
    #define SPINDLE_PWM_MAX_VALUE     1024.0 // Translates to about 1.9 kHz PWM frequency at 1/8 prescaler
    #ifndef SPINDLE_PWM_MIN_VALUE
      #define SPINDLE_PWM_MIN_VALUE   1   // Must be greater than zero.
    #endif
    #define SPINDLE_PWM_OFF_VALUE     0
    #define SPINDLE_PWM_RANGE         (SPINDLE_PWM_MAX_VALUE-SPINDLE_PWM_MIN_VALUE)

    //Control Digital Pin 8
    #define SPINDLE_TCCRA_REGISTER    TCCR4A
    #define SPINDLE_TCCRB_REGISTER    TCCR4B
    #define SPINDLE_OCR_REGISTER      OCR4C
    #define SPINDLE_COMB_BIT          COM4C1

    // 1/8 Prescaler, 16-bit Fast PWM mode
    #define SPINDLE_TCCRA_INIT_MASK ((1<<WGM40) | (1<<WGM41))
    #define SPINDLE_TCCRB_INIT_MASK ((1<<WGM42) | (1<<WGM43) | (1<<CS41))
    #define SPINDLE_OCRA_REGISTER   OCR4A // 16-bit Fast PWM mode requires top reset value stored here.
    #define SPINDLE_OCRA_TOP_VALUE  0x400 // PWM counter reset value. Should be the same as PWM_MAX_VALUE in hex.

    // Define spindle output pins.
    #define SPINDLE_PWM_DDR   DDRH
    #define SPINDLE_PWM_PORT  PORTH
    #define SPINDLE_PWM_BIT   5 // MEGA2560 Digital Pin 8

  #elif defined (SPINDLE_PWM_ON_D6)

    // Set Timer up to use TIMER4C which is attached to Digital Pin 6 - Ramps Servo 2
    #define SPINDLE_PWM_MAX_VALUE     255.0 // Translates to about 1.9 kHz PWM frequency at 1/8 prescaler
    #ifndef SPINDLE_PWM_MIN_VALUE
      #define SPINDLE_PWM_MIN_VALUE   1   // Must be greater than zero.
    #endif
    #define SPINDLE_PWM_OFF_VALUE     0
    #define SPINDLE_PWM_RANGE         (SPINDLE_PWM_MAX_VALUE-SPINDLE_PWM_MIN_VALUE)

    //Control Digital Pin 6 which is Servo 2 signal pin on Ramps 1.4 board
    #define SPINDLE_TCCRA_REGISTER    TCCR4A
    #define SPINDLE_TCCRB_REGISTER    TCCR4B
    #define SPINDLE_OCR_REGISTER      OCR4A
    #define SPINDLE_COMB_BIT          COM4A1

    // 1/8 Prescaler, 8-bit Fast PWM mode
    #define SPINDLE_TCCRA_INIT_MASK (1<<WGM41)
    #define SPINDLE_TCCRB_INIT_MASK ((1<<WGM42) | (1<<WGM43) | (1<<CS41))
    #define SPINDLE_OCRA_REGISTER   ICR4 // 8-bit Fast PWM mode requires top reset value stored here.
    #define SPINDLE_OCRA_TOP_VALUE  0xFF // PWM counter reset value. Should be the same as PWM_MAX_VALUE in hex.

    // Define spindle output pins.
    #define SPINDLE_PWM_DDR   DDRH
    #define SPINDLE_PWM_PORT  PORTH
    #define SPINDLE_PWM_BIT   3 // MEGA2560 Digital Pin 6

  #elif defined (SPINDLE_PWM_ON_D9)

    // Set Timer up to use TIMER2B which is attached to Digital Pin 9 - Ramps D9
    #define SPINDLE_PWM_MAX_VALUE     255.0 // Translates to about 1.9 kHz PWM frequency at 1/8 prescaler
    #ifndef SPINDLE_PWM_MIN_VALUE
      #define SPINDLE_PWM_MIN_VALUE   1   // Must be greater than zero.
    #endif
    #define SPINDLE_PWM_OFF_VALUE     0
    #define SPINDLE_PWM_RANGE         (SPINDLE_PWM_MAX_VALUE-SPINDLE_PWM_MIN_VALUE)

    //Control Digital Pin 9 
    #define SPINDLE_TCCRA_REGISTER    TCCR2A
    #define SPINDLE_TCCRB_REGISTER    TCCR2B
    #define SPINDLE_OCR_REGISTER      OCR2B
    #define SPINDLE_COMB_BIT          COM2B1

    // 1/8 Prescaler, 8-bit Fast PWM mode
    #define SPINDLE_TCCRA_INIT_MASK ((1<<WGM20) | (1<<WGM21))
    #define SPINDLE_TCCRB_INIT_MASK ((1<<WGM22) | (1<<CS22))
    #define SPINDLE_OCRA_REGISTER   OCR2A // 8-bit Fast PWM mode requires top reset value stored here.
    #define SPINDLE_OCRA_TOP_VALUE  0xFF  // PWM counter reset value. Should be the same as PWM_MAX_VALUE in hex.

    // Define spindle output pins.
    #define SPINDLE_PWM_DDR   DDRH
    #define SPINDLE_PWM_PORT  PORTH
    #define SPINDLE_PWM_BIT   6 // MEGA2560 Digital Pin 9

  #else
    #error "You must define SPINDLE_PWM_ON_D8 or SPINDLE_PWM_ON_D6 or SPINDLE_PWM_ON_D9 in config.h!"
  #endif


  #ifdef SEPARATE_SPINDLE_LASER_PIN

    #if defined (LASER_PWM_ON_D6)

      // Set Timer up to use TIMER4C which is attached to Digital Pin 6 - Ramps Servo 2
      #define LASER_PWM_MAX_VALUE     255.0 // Translates to about 1.9 kHz PWM frequency at 1/8 prescaler
      #ifndef LASER_PWM_MIN_VALUE
        #define LASER_PWM_MIN_VALUE   1   // Must be greater than zero.
      #endif
      #define LASER_PWM_OFF_VALUE     0
      #define LASER_PWM_RANGE         (LASER_PWM_MAX_VALUE-LASER_PWM_MIN_VALUE)

      //Control Digital Pin 6 which is Servo 2 signal pin on Ramps 1.4 board
      #define LASER_TCCRA_REGISTER    TCCR4A
      #define LASER_TCCRB_REGISTER    TCCR4B
      #define LASER_OCR_REGISTER      OCR4A
      #define LASER_COMB_BIT          COM4A1

      // 1/8 Prescaler, 8-bit Fast PWM mode
      #define LASER_TCCRA_INIT_MASK (1<<WGM41)
      #define LASER_TCCRB_INIT_MASK ((1<<WGM42) | (1<<WGM43) | (1<<CS41))
      #define LASER_OCRA_REGISTER   ICR4 // 8-bit Fast PWM mode requires top reset value stored here.
      #define LASER_OCRA_TOP_VALUE  0xFF // PWM counter reset value. Should be the same as PWM_MAX_VALUE in hex.

      // Define spindle LASER pins.
      #define LASER_PWM_DDR   DDRH
      #define LASER_PWM_PORT  PORTH
      #define LASER_PWM_BIT   3 // MEGA2560 Digital Pin 6

    #elif defined (LASER_PWM_ON_D8)

      // Set Timer up to use TIMER4B which is attached to Digital Pin 8 - Ramps 1.4 12v LASER with heat sink
      #define LASER_PWM_MAX_VALUE     1024.0 // Translates to about 1.9 kHz PWM frequency at 1/8 prescaler
      #ifndef LASER_PWM_MIN_VALUE
        #define LASER_PWM_MIN_VALUE   1   // Must be greater than zero.
      #endif
      #define LASER_PWM_OFF_VALUE     0
      #define LASER_PWM_RANGE         (LASER_PWM_MAX_VALUE-LASER_PWM_MIN_VALUE)

      //Control Digital Pin 8
      #define LASER_TCCRA_REGISTER    TCCR4A
      #define LASER_TCCRB_REGISTER    TCCR4B
      #define LASER_OCR_REGISTER      OCR4C
      #define LASER_COMB_BIT          COM4C1

      // 1/8 Prescaler, 16-bit Fast PWM mode
      #define LASER_TCCRA_INIT_MASK ((1<<WGM40) | (1<<WGM41))
      #define LASER_TCCRB_INIT_MASK ((1<<WGM42) | (1<<WGM43) | (1<<CS41))
      #define LASER_OCRA_REGISTER   OCR4A // 16-bit Fast PWM mode requires top reset value stored here.
      #define LASER_OCRA_TOP_VALUE  0x400 // PWM counter reset value. Should be the same as PWM_MAX_VALUE in hex.

      // Define spindle LASER pins.
      #define LASER_PWM_DDR   DDRH
      #define LASER_PWM_PORT  PORTH
      #define LASER_PWM_BIT   5 // MEGA2560 Digital Pin 8

    #elif defined (LASER_PWM_ON_D9)

      // Set Timer up to use TIMER2B which is attached to Digital Pin 9 - Ramps D9
      #define LASER_PWM_MAX_VALUE     255.0 // Translates to about 1.9 kHz PWM frequency at 1/8 prescaler
      #ifndef LASER_PWM_MIN_VALUE
        #define LASER_PWM_MIN_VALUE   1   // Must be greater than zero.
      #endif
      #define LASER_PWM_OFF_VALUE     0
      #define LASER_PWM_RANGE         (LASER_PWM_MAX_VALUE-LASER_PWM_MIN_VALUE)

      //Control Digital Pin 9 
      #define LASER_TCCRA_REGISTER    TCCR2A
      #define LASER_TCCRB_REGISTER    TCCR2B
      #define LASER_OCR_REGISTER      OCR2B
      #define LASER_COMB_BIT          COM2B1

      // 1/8 Prescaler, 8-bit Fast PWM mode
      #define LASER_TCCRA_INIT_MASK ((1<<WGM20) | (1<<WGM21))
      #define LASER_TCCRB_INIT_MASK ((1<<WGM22) | (1<<CS22))
      #define LASER_OCRA_REGISTER   OCR2A // 8-bit Fast PWM mode requires top reset value stored here.
      #define LASER_OCRA_TOP_VALUE  0xFF  // PWM counter reset value. Should be the same as PWM_MAX_VALUE in hex.

      // Define spindle LASER pins.
      #define LASER_PWM_DDR   DDRH
      #define LASER_PWM_PORT  PORTH
      #define LASER_PWM_BIT   6 // MEGA2560 Digital Pin 9

    #else
      #error "LASER_PWM_ON_D8 or LASER_PWM_ON_D6 or LASER_PWM_ON_D9 must be defined in config.h with the SEPARATE_SPINDLE_LASER_PIN option!"
    #endif

  #endif // SEPARATE_SPINDLE_LASER_PIN

  #ifdef USE_OUTPUT_PWM

    #if defined (OUTPUT_PWM_ON_D9)

      // Error if both spindle and analog output are defined on the same pin
      #ifdef SPINDLE_PWM_ON_D9
        #error "Spindle is already defined on D9, you cant use the same D9 pin for analog output!"
      #endif
      // Set Timer up to use TIMER2B which is attached to Digital Pin 9 - Ramps D9
      #define OUTPUT_PWM_MAX_VALUE     255.0 // Translates to about 1.9 kHz PWM frequency at 1/8 prescaler
      #ifndef OUTPUT_PWM_MIN_VALUE
        #define OUTPUT_PWM_MIN_VALUE   1   // Must be greater than zero.
      #endif
      #define OUTPUT_PWM_OFF_VALUE     0
      #define OUTPUT_PWM_RANGE         (OUTPUT_PWM_MAX_VALUE-OUTPUT_PWM_MIN_VALUE)

      //Control Digital Pin 9 
      #define OUTPUT_TCCRA_REGISTER    TCCR2A
      #define OUTPUT_TCCRB_REGISTER    TCCR2B
      #define OUTPUT_OCR_REGISTER      OCR2B
      #define OUTPUT_COMB_BIT          COM2B1

      // 1/8 Prescaler, 8-bit Fast PWM mode
      #define OUTPUT_TCCRA_INIT_MASK ((1<<WGM20) | (1<<WGM21))
      #define OUTPUT_TCCRB_INIT_MASK ((1<<WGM22) | (1<<CS22))
      #define OUTPUT_OCRA_REGISTER   OCR2A // 8-bit Fast PWM mode requires top reset value stored here.
      #define OUTPUT_OCRA_TOP_VALUE  0xFF  // PWM counter reset value. Should be the same as PWM_MAX_VALUE in hex.

      // Define spindle output pins.
      #define OUTPUT_PWM_DDR   DDRH
      #define OUTPUT_PWM_PORT  PORTH
      #define OUTPUT_PWM_BIT   6 // MEGA2560 Digital Pin 9

    #elif defined (OUTPUT_PWM_ON_D8)

      // Error if both spindle and analog output are defined on the same pin
      #ifdef SPINDLE_PWM_ON_D8
        #error "Spindle is already defined on D8, you cant use the same D8 pin for analog output!"
      #endif
      // Error when analog output and spindle use the same timer
      #ifdef SPINDLE_PWM_ON_D6
        #error "Spindle is defined on D6 which use the same timer than D8, you cant use D8 pin for analog output!"
      #endif
      // Set Timer up to use TIMER4B which is attached to Digital Pin 8 - Ramps 1.4 12v output with heat sink
      #define OUTPUT_PWM_MAX_VALUE     1024.0 // Translates to about 1.9 kHz PWM frequency at 1/8 prescaler
      #ifndef OUTPUT_PWM_MIN_VALUE
        #define OUTPUT_PWM_MIN_VALUE   1   // Must be greater than zero.
      #endif
      #define OUTPUT_PWM_OFF_VALUE     0
      #define OUTPUT_PWM_RANGE         (OUTPUT_PWM_MAX_VALUE-OUTPUT_PWM_MIN_VALUE)

      //Control Digital Pin 8
      #define OUTPUT_TCCRA_REGISTER    TCCR4A
      #define OUTPUT_TCCRB_REGISTER    TCCR4B
      #define OUTPUT_OCR_REGISTER      OCR4C
      #define OUTPUT_COMB_BIT          COM4C1

      // 1/8 Prescaler, 16-bit Fast PWM mode
      #define OUTPUT_TCCRA_INIT_MASK ((1<<WGM40) | (1<<WGM41))
      #define OUTPUT_TCCRB_INIT_MASK ((1<<WGM42) | (1<<WGM43) | (1<<CS41))
      #define OUTPUT_OCRA_REGISTER   OCR4A // 16-bit Fast PWM mode requires top reset value stored here.
      #define OUTPUT_OCRA_TOP_VALUE  0x400 // PWM counter reset value. Should be the same as PWM_MAX_VALUE in hex.

      // Define spindle output pins.
      #define OUTPUT_PWM_DDR   DDRH
      #define OUTPUT_PWM_PORT  PORTH
      #define OUTPUT_PWM_BIT   5 // MEGA2560 Digital Pin 8

    #elif defined (OUTPUT_PWM_ON_D6)

      // Error if both spindle and analog output are defined on the same pin
      #ifdef SPINDLE_PWM_ON_D6
        #error "Spindle is already defined on D6, you cant use the same D6 pin for analog output!"
      #endif
      // Error when analog output and spindle use the same timer
      #ifdef SPINDLE_PWM_ON_D8
        #error "Spindle is defined on D8 which use the same timer than D6, you cant use D6 pin for analog output!"
      #endif
      // Set Timer up to use TIMER4C which is attached to Digital Pin 6 - Ramps Servo 2
      #define OUTPUT_PWM_MAX_VALUE     255.0 // Translates to about 1.9 kHz PWM frequency at 1/8 prescaler
      #ifndef OUTPUT_PWM_MIN_VALUE
        #define OUTPUT_PWM_MIN_VALUE   1   // Must be greater than zero.
      #endif
      #define OUTPUT_PWM_OFF_VALUE     0
      #define OUTPUT_PWM_RANGE         (OUTPUT_PWM_MAX_VALUE-OUTPUT_PWM_MIN_VALUE)

      //Control Digital Pin 6 which is Servo 2 signal pin on Ramps 1.4 board
      #define OUTPUT_TCCRA_REGISTER    TCCR4A
      #define OUTPUT_TCCRB_REGISTER    TCCR4B
      #define OUTPUT_OCR_REGISTER      OCR4A
      #define OUTPUT_COMB_BIT          COM4A1

      // 1/8 Prescaler, 8-bit Fast PWM mode
      #define OUTPUT_TCCRA_INIT_MASK (1<<WGM41)
      #define OUTPUT_TCCRB_INIT_MASK ((1<<WGM42) | (1<<WGM43) | (1<<CS41))
      #define OUTPUT_OCRA_REGISTER   ICR4 // 8-bit Fast PWM mode requires top reset value stored here.
      #define OUTPUT_OCRA_TOP_VALUE  0xFF // PWM counter reset value. Should be the same as PWM_MAX_VALUE in hex.

      // Define spindle output pins.
      #define OUTPUT_PWM_DDR   DDRH
      #define OUTPUT_PWM_PORT  PORTH
      #define OUTPUT_PWM_BIT   3 // MEGA2560 Digital Pin 6

    #else
      #error "OUTPUT_PWM_ON_D9 or OUTPUT_PWM_ON_D8 or OUTPUT_PWM_ON_D6 must be defined in config.h with the USE_OUTPUT_PWM option!"
    #endif

  #endif // USE_OUTPUT_PWM

#endif // CPU_MAP_2560_RAMPS_BOARD


#endif
