weng1259/autospin/migration_snapshot/2026-07-25/src/webapp/routes_devices.py

"""外设 Web 端点；仅滑台立即停止绕过全局 operation 门闸。"""

# 安全禁令：``/api/linearstage/stop`` 是与急停同级的立即停止路径，永远不得
# 增加 operation/busy 门闸、应用层锁、排队或后台线程；其余本文件端点全部
# 必须经 OperationGate 后台执行。
from __future__ import annotations

from typing import Literal

from fastapi import FastAPI, Request
from fastapi.responses import JSONResponse
from pydantic import BaseModel, ConfigDict, Field

from ..hardware.errors import L3Error
from ..hardware.gripper_backend import GripperBackend
from ..hardware.heater_backend import HeaterBackend
from ..hardware.linearstage_backend import (
    LinearStageActionResult,
    LinearStageBackend,
)
from ..hardware.pipette_backend import PipetteBackend
from ..hardware.relay_backend import RelayBackend
from ..hardware.spincoater_backend import SpincoaterBackend
from .auth import error_envelope
from .gate import Operation, OperationGate
from .registry import DeviceRegistry


class EmptyRequest(BaseModel):
    """无参数 POST 的显式请求体。"""

    model_config = ConfigDict(extra="forbid")


class IdempotencyRequest(EmptyRequest):
    """允许调用方复用 backend 幂等键；缺省时使用 operation id。"""

    idempotency_key: str | None = Field(default=None, min_length=1)


class HeaterSetSvRequest(IdempotencyRequest):
    """加热台目标温度请求。"""

    sv_c: float = Field(allow_inf_nan=False)


class SpinStartRequest(IdempotencyRequest):
    """旋涂启动请求。"""

    rpm: float = Field(allow_inf_nan=False)


class SpinStopRequest(IdempotencyRequest):
    """旋涂停止请求；默认使用制动。"""

    use_brake: bool = True


class PipetteVolumeRequest(IdempotencyRequest):
    """移液枪吸液或排液体积请求。"""

    volume_ul: float = Field(allow_inf_nan=False)


class LinearStageMoveRequest(IdempotencyRequest):
    """滑台绝对位置请求。"""

    position_mm: float = Field(allow_inf_nan=False)


class RelayChannelRequest(IdempotencyRequest):
    """通用继电器请求；CH1/CH2 在 Web 边界永久禁用。"""

    channel: int = Field(ge=3, le=8)
    on: bool


class AcceptedOperation(BaseModel):
    """所有被门闸接纳的外设操作统一响应。"""

    operation_id: str
    accepted: Literal[True] = True


class DeviceNotAttachedError(L3Error):
    """Web 注册表没有接入所请求的设备。"""

    error_code = "L3.DEVICE_NOT_ATTACHED"
    severity = "warning"
    recoverable = True
    suggested_action = "Attach the device backend before retrying."
    suggested_action_zh = "先接入对应设备后端，再重试。"


def _get_heater(registry: DeviceRegistry) -> HeaterBackend:
    heater = registry.heater
    if heater is None:
        raise DeviceNotAttachedError(
            human_message="加热台后端未接入。",
            agent_message="DeviceRegistry.heater is not attached.",
        )
    return heater


def _get_spincoater(registry: DeviceRegistry) -> SpincoaterBackend:
    spincoater = registry.spincoater
    if spincoater is None:
        raise DeviceNotAttachedError(
            human_message="旋涂后端未接入。",
            agent_message="DeviceRegistry.spincoater is not attached.",
        )
    return spincoater


def _get_pipette(registry: DeviceRegistry) -> PipetteBackend:
    pipette = registry.pipette
    if pipette is None:
        raise DeviceNotAttachedError(
            human_message="移液枪后端未接入。",
            agent_message="DeviceRegistry.pipette is not attached.",
        )
    return pipette


def _get_linear_stage(registry: DeviceRegistry) -> LinearStageBackend:
    linear_stage = registry.linear_stage
    if linear_stage is None:
        raise DeviceNotAttachedError(
            human_message="滑台后端未接入。",
            agent_message="DeviceRegistry.linear_stage is not attached.",
        )
    return linear_stage


def _get_relay(registry: DeviceRegistry) -> RelayBackend:
    relay = registry.relay
    if relay is None:
        raise DeviceNotAttachedError(
            human_message="继电器后端未接入。",
            agent_message="DeviceRegistry.relay is not attached.",
        )
    return relay


def _get_gripper(registry: DeviceRegistry) -> GripperBackend:
    gripper = registry.gripper
    if gripper is None:
        raise DeviceNotAttachedError(
            human_message="夹爪后端未接入。",
            agent_message="DeviceRegistry.gripper is not attached.",
        )
    return gripper


def _accepted(operation: Operation) -> AcceptedOperation:
    return AcceptedOperation(operation_id=operation.id)


def _idempotency_key(
    request: IdempotencyRequest,
    operation: Operation,
) -> str:
    return request.idempotency_key or operation.id
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
