weng1259/autospin/(commit log)

2026-06-17 chore: Pi fresh init — 用户 repo 安全子集迁移打底 (Chunk 1)
    以用户「智能旋涂仪」repo 为基础，迁移安全子集到树莓派作为开发主线 SoR。
    - 全新 git 历史（不带 Mac 560M 历史与护城河，留 Mac 私有档案）
    - 含 src/tests/tools/docs 技术规范 + ADR-006 + issues 027-029 + phase-3.3 验收 + AGENTS
    - 敏感策略文档天然排除（未跟踪）；.gitignore 追加防护段防未来误提交
    - 清理噪音：Code/perovskite 旧师兄副本 + tracked 稳定性日志
    共 220 文件。Chunk 2 起拉师兄净新增部分（5 驱动 / protocol / wrapper / web_control / maestro）。
    [GH40-D75-X300S-Y300S-Z100S-57.STEP, grbl_settings.txt]
2026-06-17 feat: 装箱师兄净新增栈 → autospin_system/ (Chunk 2)
    把师兄全栈（除分叉的 l3_backend）整体装箱进 autospin_system/ 子包，保留师兄包结构（36 行相对 import 不动），作"师兄净新增 import 快照"。
    - 含：5 驱动(spin_motor/pipette/heating_stage/relay) + Z2 设备层 + protocol/ + config/ + web_control/ + maestro/system/workers + 12 测试 + 脚本 + 手册/部署文档
    - 不带：hardware/xyz_stage/l3_backend/（分叉 L3，被 src/ 取代；Chunk 3 接 import）
    - 排除：.git / __pycache__ / 空目录(analysis/closedloop/experimentaldesign)
    - 命名 autospin_system 取师兄 repo 原名（中性、师兄认同）
    待 ADR-004 包壳（Chunk 5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
2026-06-17 feat: 统一 L3 + 接通全栈 import (Chunk 3)
    forward-port 三方合并的统一 L3 (含师兄 Z2/manual-mode) 进 src/，全仓只剩
    一份 L3；师兄全栈 import 全部指向 src.* / autospin_system.*。
    forward-port:
    - src/hardware/{gantry_backend,types}.py 落 bro-ref 88678fd 统一版
    (relay/errors/schema_export/gripper 已与 src 一致，未动)。
    - gantry +550 行 = 师兄 Z2/A轴/manual-mode；types +z2_mm/limit_pins。
    用户 #025/grbl 自检全部保留 (符号计数逐项核对，superset)。
    - mypy 卫生 (维持 src/ strict 全绿): get_homing_diagnostics -> dict[str,object]；
    settings.get(key)->settings[key] (受 in 守卫，行为不变)。
    导入拓扑:
    - 新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
    [gantry_backend.py, heating_stage_controller.py, motor_controller.py, pipette_controller.py, test_rs485_bus.py, types.py]
2026-06-19 Chunk 4: RS485/串口配置归一到 Pi udev 名（修师兄 hwid 贴错 grbl CH340）
    - system_config.yaml: communication 端口全切 Pi udev 稳定名
    (rs485_bus/motor/pipette/heating -> /dev/autospin_rs485,
    relay -> /dev/autospin_relay, gantry -> /dev/autospin_xyz)
    - 修正死字段 hwid_keyword: spin_motor/heating -> 04E2:1411(Exar),
    relay -> 0483:5740(STM32); 注明其仅作记录、不参与端口解析
    - maestro.py: 抽出 resolve_serial_ports() 单一真相源；回退默认值改
    udev 名（缺字段也不会撞 grbl 口）
    - 新增 test_port_mapping.py (6 tests): 端口映射 / 除龙门外不抢 grbl 口 /
    共享桥 / 按设备 baud+slave_id / fallback 安全
    验收: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
2026-06-19 面板：加限位感知 jog（X/Y/Z）+ Z2 控件 + 串口归一到 Pi
    - GantryBackend.jog(): @observable + Pn 前置检查 + Z 刹车 + $J=G91
    + 已归零时软限位校验（净增 79 行，未动现有方法）
    - SoftLimits: ±0.01mm 容差修 grbl pull-off 浮点漂移
    - 面板 jog 区: X±/Y±/Z± + step/feed 选择器 + Pn 限位禁用 + 未归零警告
    - 面板 Z2 区: 初始化/步进/预设(0-125)/park（调用现有 Z2 后端方法）
    - 面板实时位置: Pn 限位状态红色警告
    - 串口默认值改 Pi by-id 路径（grbl + relay）
    - 错误消息去掉硬编码 Mac 串口路径
    137 tests / mypy strict 0 / schema 含 jog
2026-06-20 udev: 串口稳定命名纳入 repo + 注释修正（两 CH340 按物理口区分）
    deploy/udev/: 99-autospin.rules 副本 + 幂等自愈 install.sh + README。grbl 与 RS485 模块同为 CH340(1a86:7523)、无唯一序列号，只能按物理 USB 口 KERNELS 锁定（1-1=grbl→autospin_xyz, 1-2=RS485 模块→autospin_rs485/heater，relay STM32 按 hwid）。坑：KERNELS 必须用 USB 设备层 1-1 而非接口层 1-1:1.0，否则与 ATTRS{idVendor} 落在不同节点静默失配。install.sh 清残留软链+触发 add 事件重建，修复插拔后软链不刷新（陈旧链接可能指错设备）。
    system_config.yaml / test_port_mapping.py: RS485 三设备注释 Exar(04E2:1411)→CH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
2026-06-20 面板：增量集成全设备（夹爪/工艺CH3-8/加热/旋涂）— PM 手动旋涂预演
    照 task-panel-full-device-integration.md 在 emergency_dashboard.py 纯净增
    423 行（0 删、不改写已有行），复用既有龙门 UI（jog/move/home/Z2/急停/恢复）。
    架构（任务卡 §1，真机坐实）：
    - RelayBackend 单一实例注入 GantryBackend(relay=)，自己开夹爪 CH1 + 工艺 CH3-8；
    绝不 new 第二个 relay（gantry._relay is relay = gripper._relay is relay = True）。
    - 加热(slave3)+旋涂(slave2)两个 SharedRs485DeviceProxy 共用一把 threading.Lock
    串行化同一条 RS485（heater._lock is spin._lock = True），open-use-close。
    - 不构造 Pip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
2026-06-29 移液 driver 修复: 动作码低半区+1 / home 轮询 homed+超时 IMM_STOP 刹车 / 位置原子读 signed
    - ActionCode 低半区整体 +1（设备 1 起步）: HOME 0x00->0x01（命门，6-20 误写空闲码 0x00 导致归位从不触发）, 至 IMM_STOP 0x08 / LIQ_DETECT 0x09; ASPIRATE/DISPENSE/DROP_TIP 保持 0x0A/0x0B/0x0C; 加 IDLE=0x00
    - home(): 轮询 homed(input reg1)+started 门, 下命令前 IDLE->HOME 制造边沿, 超时发 IMM_STOP(0x08) 刹车（不再放任电机跑）
    - get_actual_position(): read_input_registers(POS_H,2) 原子读 + 32 位 signed（消除 -65572 撕裂鬼值）
    - 合入参考仓 PM 早先未提交改动: _wait_for_action_cycle / aspirate detect_mask 校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
    [pipette_controller.py]
2026-06-29 移液 driver: 运动默认参数改回手册建议值 50/1250/1250
    _initialize_pipette / start() 用 DEFAULT_SPEED/ACCEL/DECEL=10/20/20 覆盖了 flash
    里手册建议的 50/1250/1250，把速度压到最慢(1 r/s)、加减速压到极小，导致 home()
    在 30s 超时内跑不完整段粗找行程。
    真机实测(2026-06-29 PM 在场)：VEL=10 时 30s 只走到 pos=5786 没够光耦(误判超时)；
    VEL=40 时 3.8s 干净跑完归位(粗找 15367 撞光耦→回 0, homed 0→1)。
    手册 §5.1.2 保持寄存器：速度建议 50(0.1转/秒)、加/减速建议 1250。改回建议值。
2026-07-06 chore: 剔除 149MB 产品画册 PDF 出仓（超 GitHub 100MB 硬限），实体备份 ~/autospin-assets/
2026-07-16 示教-重放 routine 模块 + 面板全设备集成入库 (2026-06-29/07-06 会话遗留收编): RecordingProxy/RoutinePlayer + 加热/旋涂/夹爪/继电器进 Streamlit 面板
2026-07-16 旋涂电机 bringup 验收文档 + 工具入库 (2026-06-20 gate 已过)
2026-07-16 Z2/串口/移液诊断工具入库
2026-07-16 W0: 绿基线一条命令 scripts/check.sh + Codex 任务卡 W0-R/W1.0/W1.1 (施工计划见 Mac docs/decision-log/web-control-catchup-plan.md)
2026-07-16 W0-R (Codex): README 现状化 + RunLog SQLite 连接泄漏修复 (pytest 收集限制 Pi 已有配置, 未采用 Mac 版)
    [runlog.py, test_runlog.py]
2026-07-16 W1.0 Rs485Bus 共享总线管理器 (Codex 产出) + 审查补丁: 事务级 timeout 兜底 + exclusive 独占锁
2026-07-16 schema_export: PEP 604 Union 渲染跨 Python 3.13/3.14 规范化 (消除 Mac/Pi 合同假红)
2026-07-16 任务卡 W1.2 旋涂 / W1.3 移液 backend
2026-07-16 check.sh: venv 位置自适应 (Pi .venv / Mac tools/spikes/.venv)
2026-07-16 W1.1 HeaterBackend (Codex 产出, 审查通过无补丁): AI-516P Modbus 壳 + 假总线测试 + 合同注册 + smoke 脚本(只写不跑)
2026-07-16 W1.2 Spincoater / W1.3 Pipette backend (Codex 产出) + 三后端审查补丁批次 (细粒度历史见 Mac 档案): P0 旋涂0x8005直写RPM / P1 0x801B低字节 / 清输入缓冲 / close不关总线 / dry_run不进幂等缓存
2026-07-16 W1.2 卡文纠错: speed_factor 只是 0x8018 回读解码系数 (P0 根因)
2026-07-16 任务卡 W1.4 Emm 滑台 backend + 师兄参考驱动收编
2026-07-16 W1.4 LinearStageBackend (Codex 产出) + 审查补丁: P1 归零前清堵转保护/触发后先睡再查 / P2 move前使能+归零后0x36闭环校验 (细粒度历史见 Mac 档案)
2026-07-16 W1.5 Z2/A 轴退役: gantry 三轴模型恢复, 面板 Z2 控件撤除, 合同 breaking: Position 移除 z2_mm (物理上 2026-06-30 已由 Emm 滑台取代)
2026-07-16 W2 系统急停: SystemEstop.halt_all 固定顺序 + 步级故障隔离 + 信号接线 + PipetteBackend.stop; EstopReport 入合同
2026-07-16 W3 卡组 (7张小卡)
2026-07-16 W3.0-3.2 Web 服务: 骨架+token鉴权 / 无锁急停+状态SSE / operation门闸+龙门端点 (Codex 产出 + 审查补丁批次, 细粒度历史见 Mac 档案)
2026-07-16 W3.3 外设端点: 六设备全过门闸 / 滑台stop直通急停语义 / relay CH1-2 硬拒绝 / NaN-Infinity 边界回归锚 (Codex 产出 + 审查补丁, Mac aec9b6d+e8874f8)
2026-07-16 W3.4 前端骨架: 无构建链单页+状态栏SSE+急停独立fetch / GET静态窄豁免 / 设计规范CI断言 (Mac a2cfb22)
2026-07-16 W3.3b 生命周期端点对称: 四设备 disconnect + relay connect/disconnect (Mac 4feb04c)
2026-07-16 W3.4b mock注册表活体化: 七内存假设备+SystemEstop接五设备 (Mac 同名commit)
2026-07-16 W3.5 七设备面板: 读数+控件+pending解禁+409提示 (Mac 同名commit)
2026-07-16 W3.6 示教-重放: 录制代理+原子存盘+门闸重放+直通abort+程序面板 (Codex 产出 + 审查P1补丁, Mac 73dc756)
2026-09-20 feat: consolidate automation runtime and correct spin timing
    [hardware.yaml]
2026-09-21 chore: prepare autospin project upload
    [hardware.yaml]
2026-09-25 Organize report archive materials
    [hardware.yaml]
