weng1259/autospin/(notices)

Notices in the files:
firmware/grbl_spike/our_config/config.h:
Copyright (c) 2009-2011 Simen Svale Skogsrud
Grbl is free software: you can redistribute it and/or modify
it under the terms of the GNU General Public License as published by
the Free Software Foundation, either version 3 of the License, or
(at your option) any later version.
